natsfr/kicad-components/python_plugins/README

Use of foot print wizard:
 - Linux: ~/.kicad_plugins/
 - Windows: InstallPath\KiCad\share\kicad\scripting\plugins
