natsfr/kicad-components/python_plugins/qfn_generator_1.png

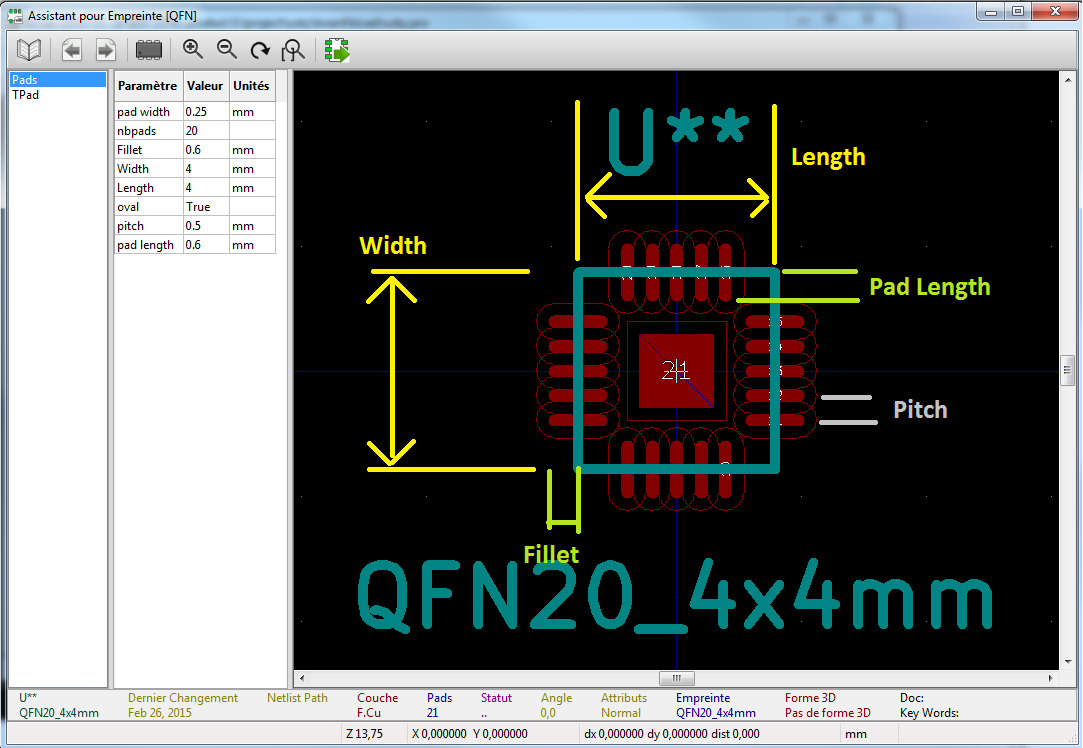
python_plugins/qfn_generator_1.png
