natsfr/kicad-components/python_plugins/qfn_generator_2.png

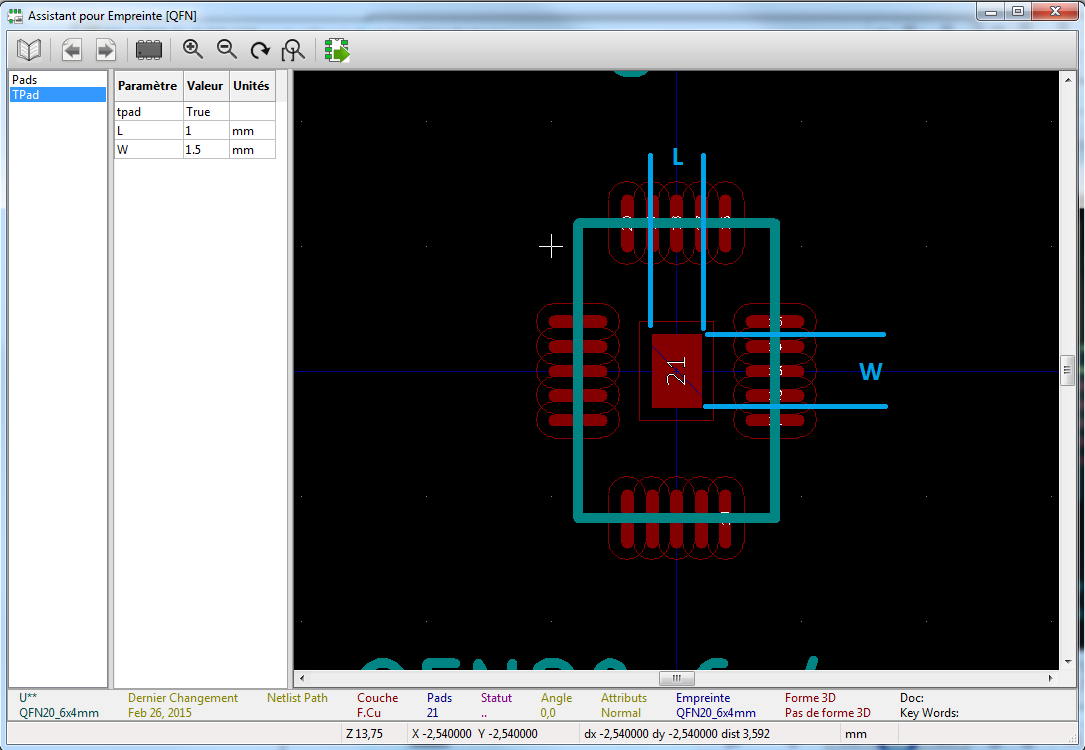
python_plugins/qfn_generator_2.png
