natsfr/kicad-components/python_plugins/qfn_generator_3.png

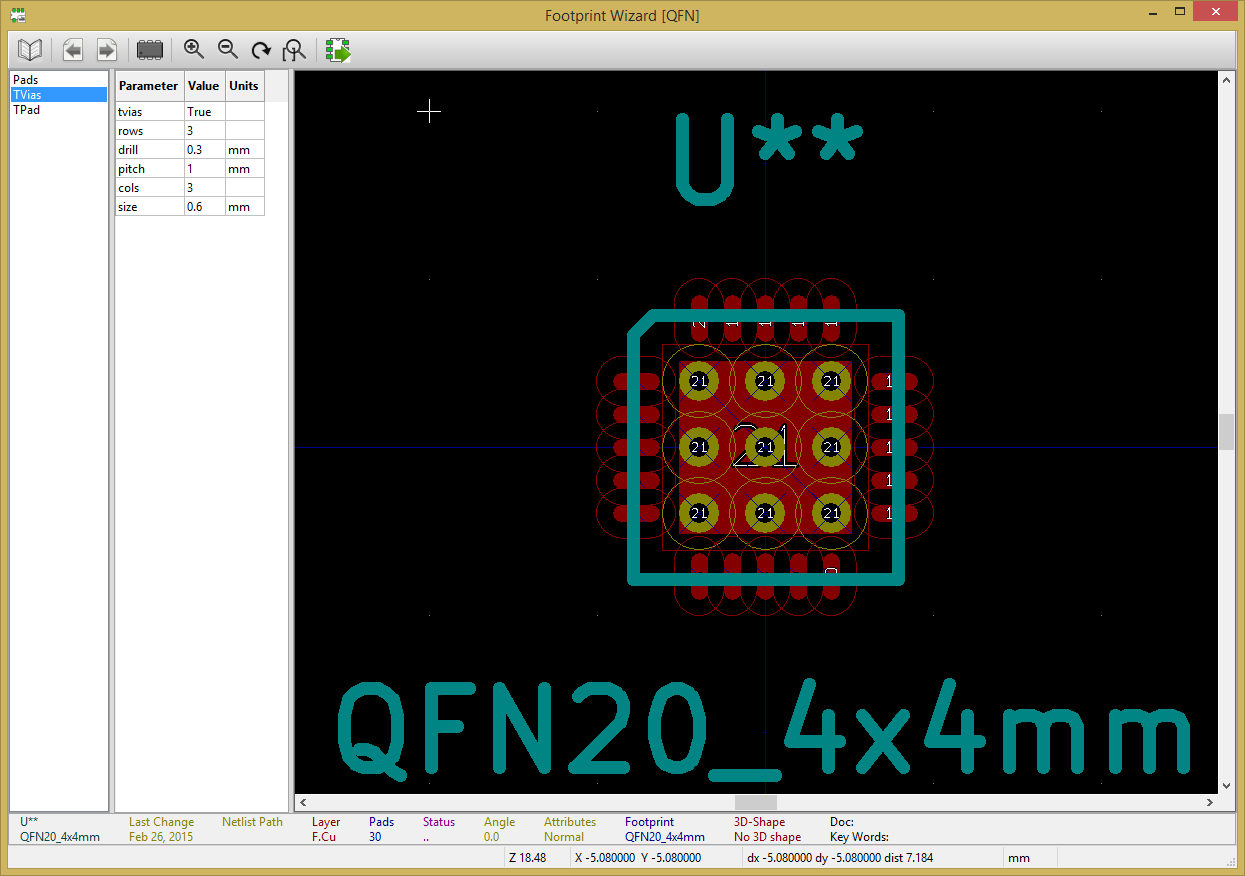
python_plugins/qfn_generator_3.png
