natsfr/kicad-components/3D_Models/Cherry/asm_mx_asm_PCB.stp

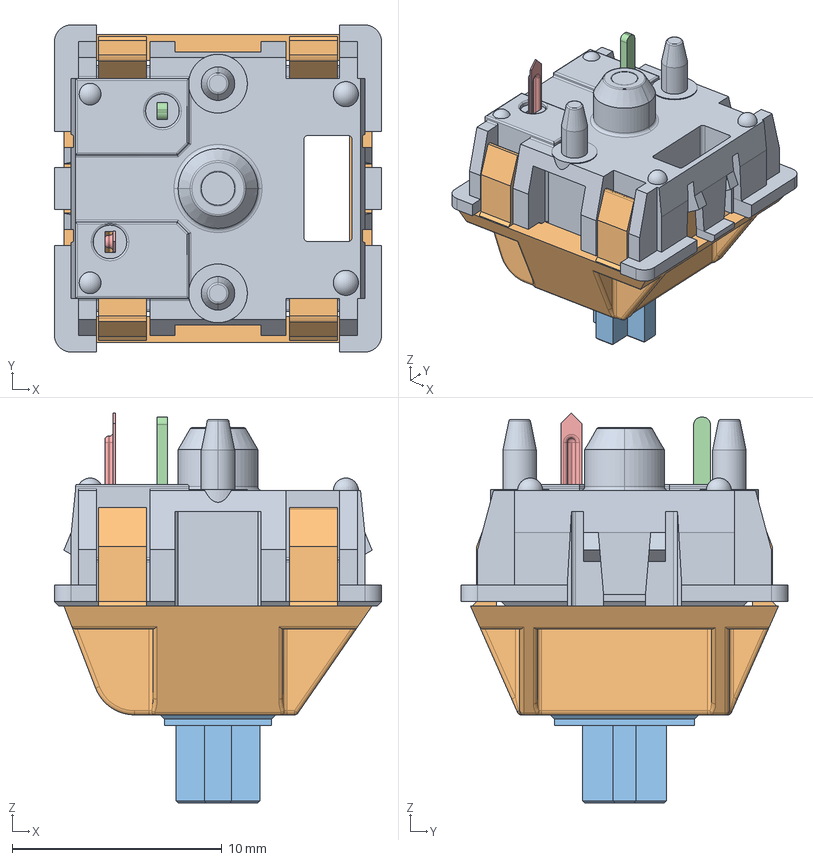
[picture p4: CAD file, 2021-11-10]
3D_Models/Cherry/asm_mx_asm_PCB.stp
15.6 x 15.6 x 18.6 mm
MX_DOWN
MX_UP
UP_MX
MX_PIN
MX_SPRING
MX_CLICK
