natsfr/kicad-components/3D_Models/Laird/bmi-s-209-assembly-stp-file.STEP

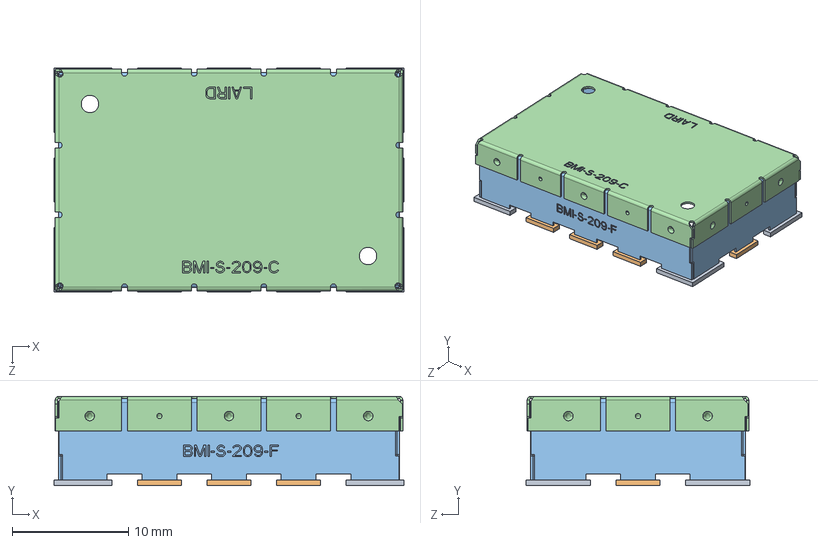
[picture p5: CAD file, 2021-12-20]
3D_Models/Laird/bmi-s-209-assembly-stp-file.STEP
30.2 x 7.70 x 19.3 mm
bmi-s-209-footprint
bmi-s-209-f
bmi-s-209-c
