natsfr/kicad-components/3D_Models/Connectors_RF/SMA_CINCH_142-0701-801_complete.step

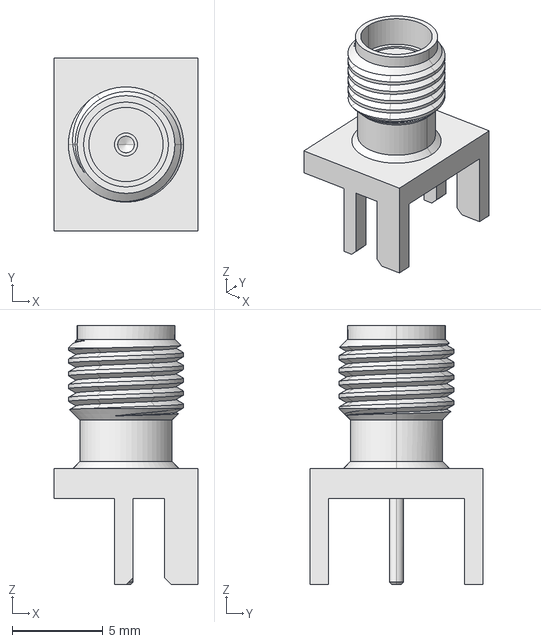
[picture p6: CAD file, 2019-05-17]
3D_Models/Connectors_RF/SMA_CINCH_142-0701-801_complete.step
7.92 x 9.53 x 14.3 mm
