natsfr/kicad-components/3D_Models/ALPS/SKSUBCE010.step

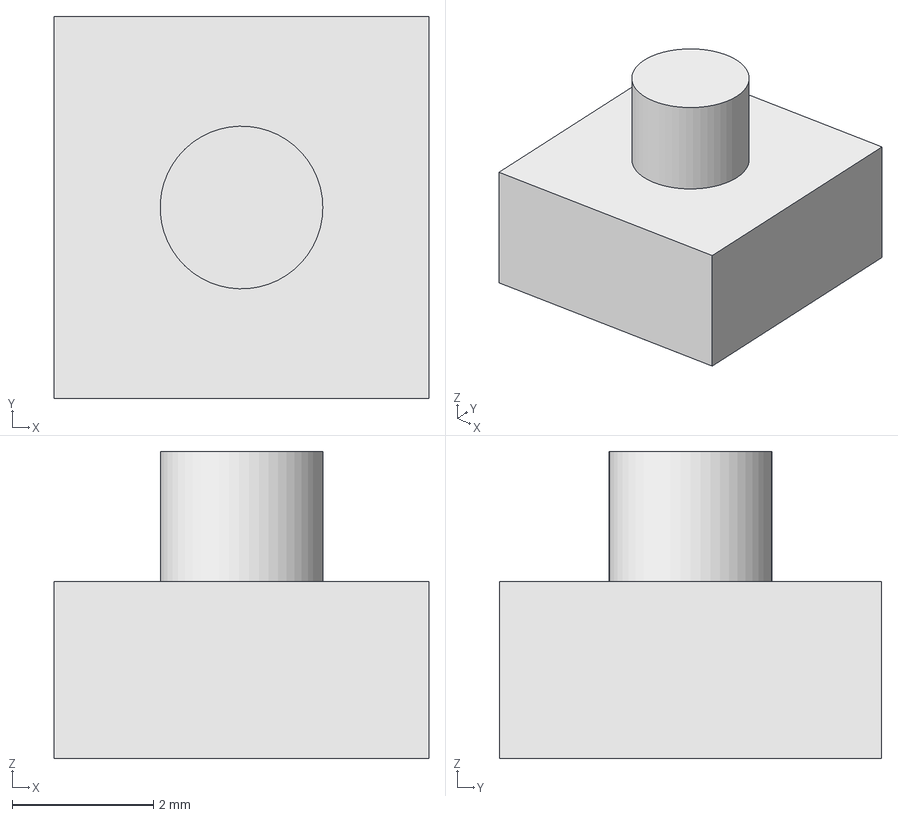
[picture p7: CAD file, 2024-10-08]
3D_Models/ALPS/SKSUBCE010.step
5.30 x 5.40 x 4.34 mm
