natsfr/kicad-components/3D_Models/Amphenol/SFP-U77A1118X00X.STEP

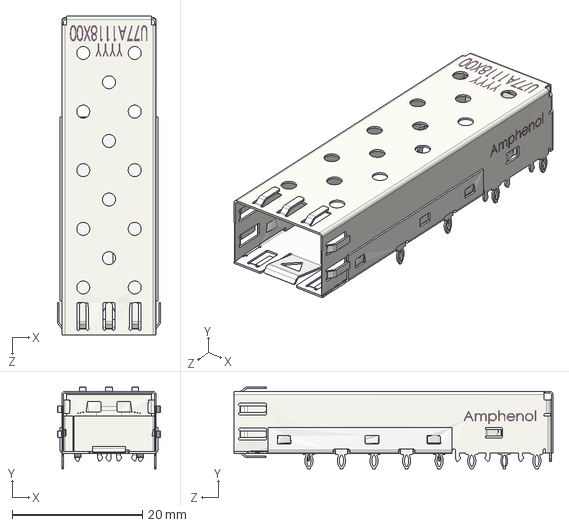
[picture p8: CAD file, 2021-12-20]
3D_Models/Amphenol/SFP-U77A1118X00X.STEP
15.8 x 12.6 x 49.0 mm
