natsfr/kicad-components/3D_Models/Antenna/custom_868.step

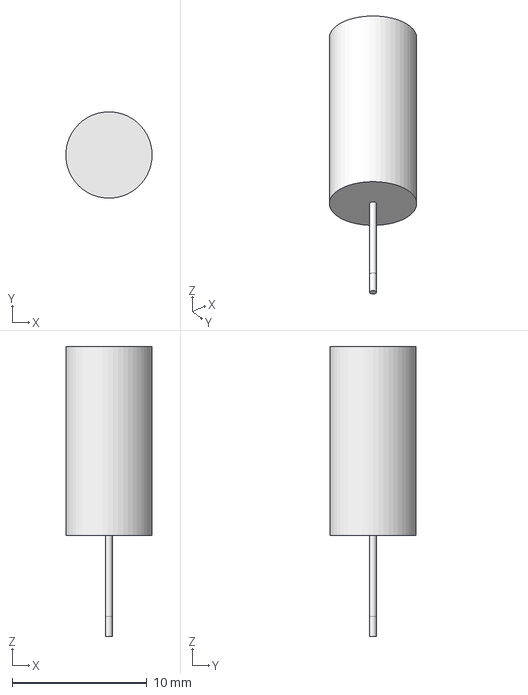
[picture p9: CAD file, 2024-10-08]
3D_Models/Antenna/custom_868.step
6.39 x 6.40 x 21.5 mm
