natsfr/kicad-components/3D_Models/Basic/3.2x2.5x2.5mm.step

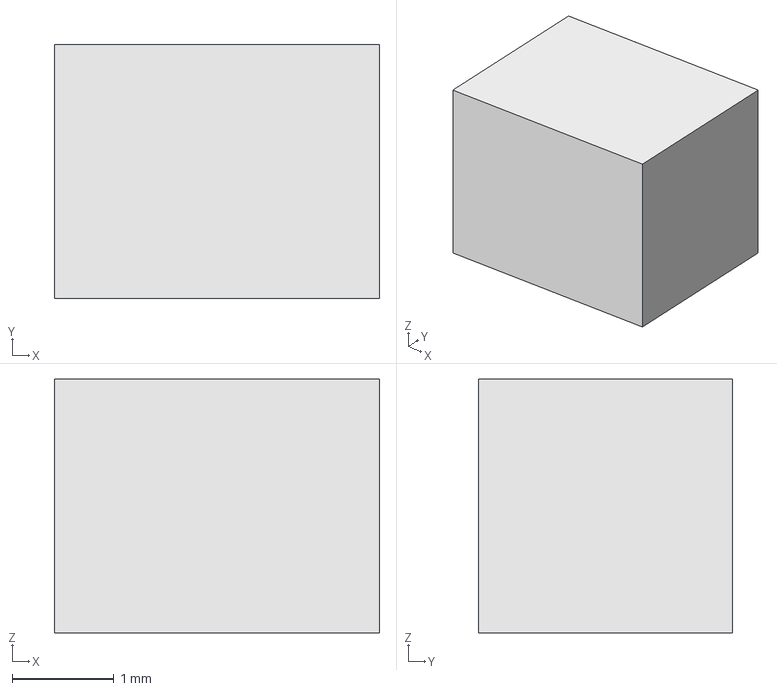
[picture p10: CAD file, 2026-04-01]
3D_Models/Basic/3.2x2.5x2.5mm.step
3.20 x 2.50 x 2.50 mm
