natsfr/kicad-components/3D_Models/Bourns/2038-xx-sm.stp

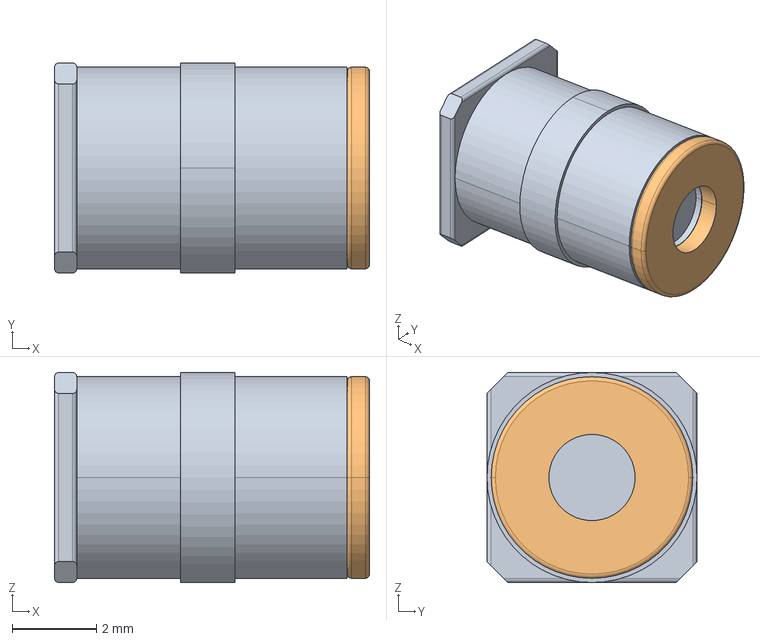
[picture p11: CAD file, 2026-08-12]
3D_Models/Bourns/2038-xx-sm.stp
7.50 x 5.00 x 5.00 mm
