natsfr/kicad-components/3D_Models/CK_Switch/KSC441J DCT.stp

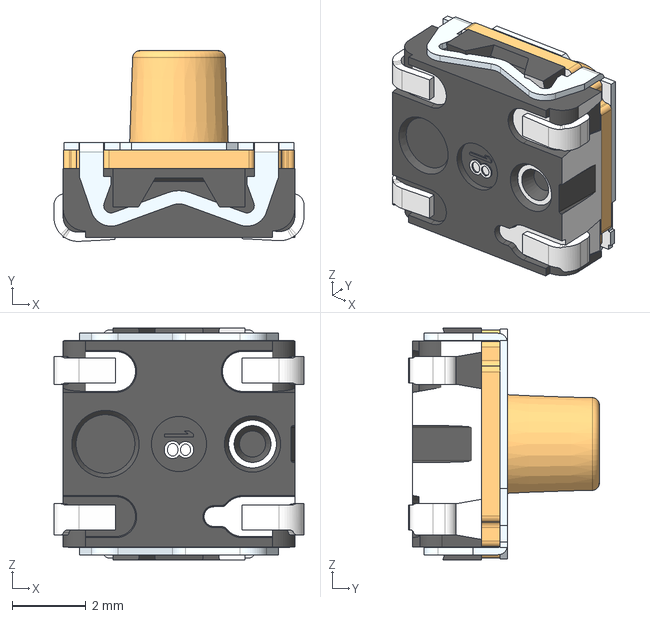
[picture p12: CAD file, 2020-06-26]
3D_Models/CK_Switch/KSC441J DCT.stp
6.80 x 5.19 x 6.30 mm
