natsfr/kicad-components/3D_Models/Coilcraft/Coilcraft-MSD7342.STEP

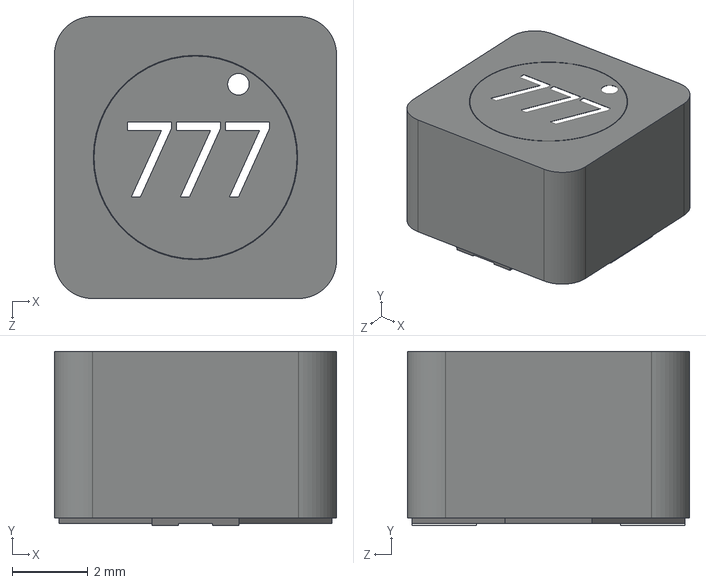
[picture p13: CAD file, 2025-06-05]
3D_Models/Coilcraft/Coilcraft-MSD7342.STEP
7.45 x 4.60 x 7.45 mm
