natsfr/kicad-components/3D_Models/ComputeUnit/PinSocket_2x13_P2.54mm_Vertical.step

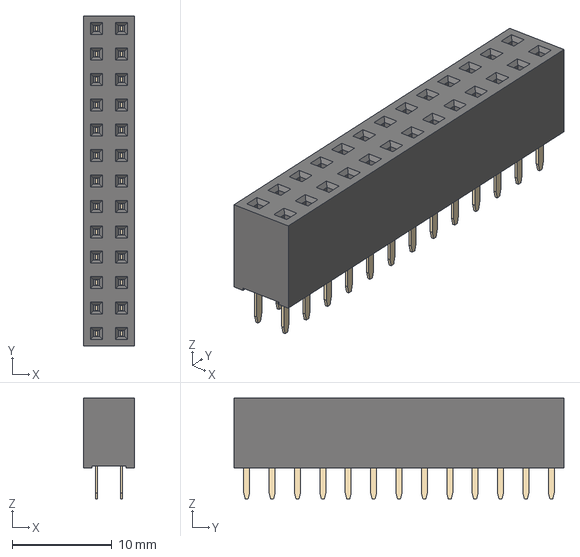
[picture p14: CAD file, 2022-07-30]
3D_Models/ComputeUnit/PinSocket_2x13_P2.54mm_Vertical.step
5.08 x 33.0 x 10.1 mm
