natsfr/kicad-components/3D_Models/Connector_0.8mm/QTE-014-03-F-D-DP-A.stp

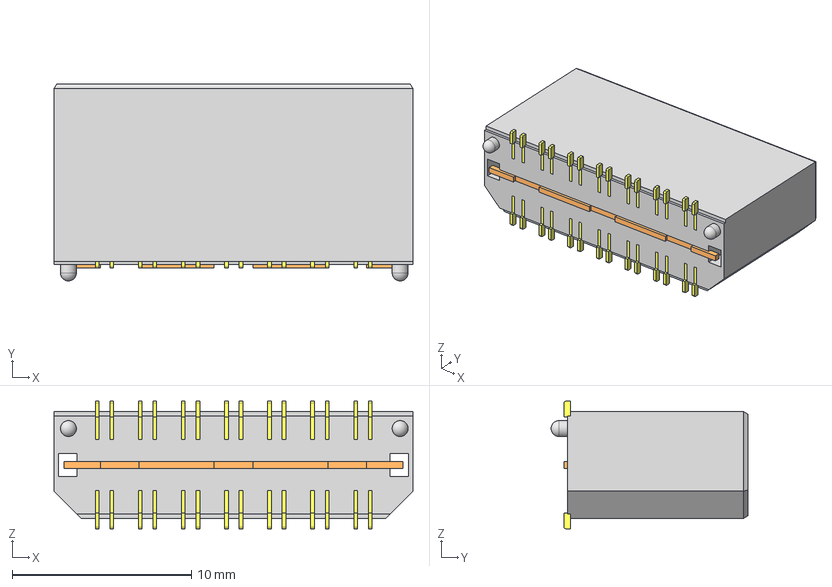
[picture p15: CAD file, 2022-07-30]
3D_Models/Connector_0.8mm/QTE-014-03-F-D-DP-A.stp
20.0 x 11.0 x 7.11 mm
_QTE-014-03-D-DP-At
_PT-1S60-03(014-03-D-DP)
_QTE-T-1G1-03_imp
