natsfr/kicad-components/3D_Models/Connector_1.27mm/FTS-110-01-L-D.stp

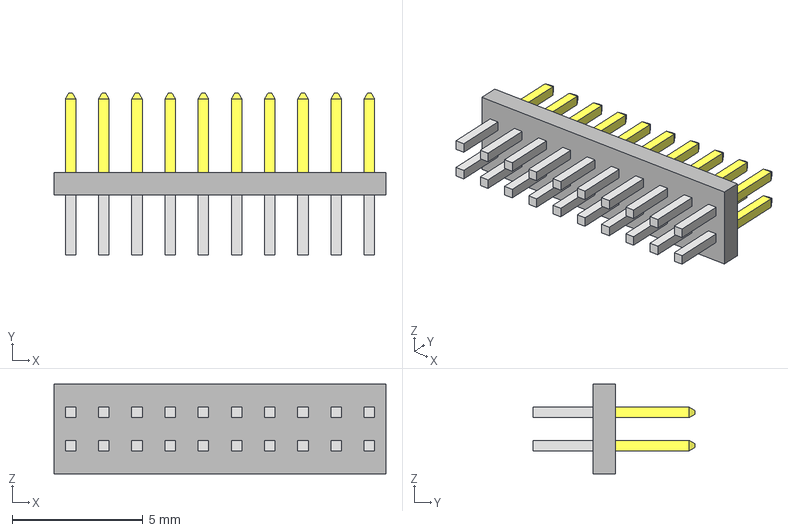
[picture p16: CAD file, 2019-06-12]
3D_Models/Connector_1.27mm/FTS-110-01-L-D.stp
12.7 x 6.20 x 3.43 mm
_FTS-110-01-L-D_body
_FTS-110-01-L-D_pins1
_FTS-110-01-L-D_pins2
