natsfr/kicad-components/3D_Models/Connectors_RF/SMA ANGLED.STEP

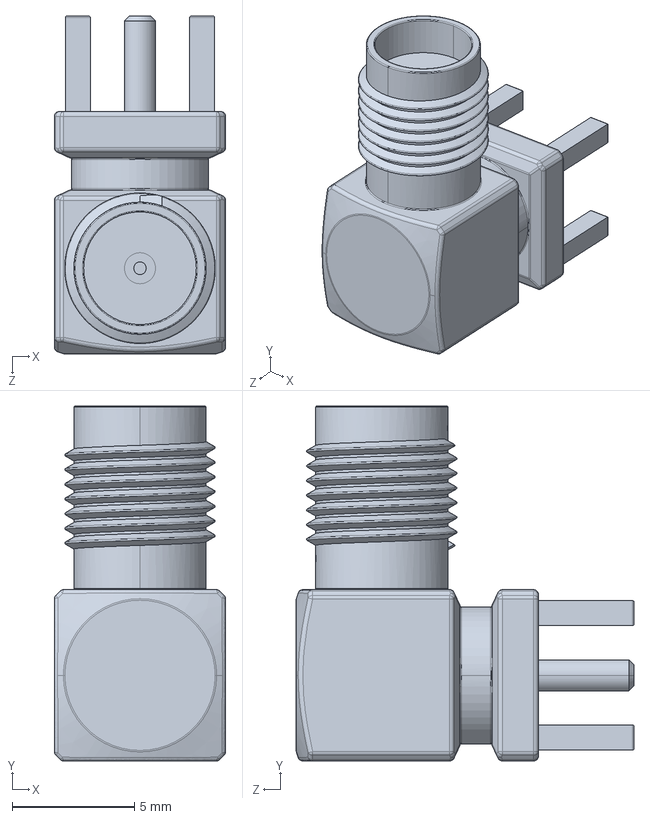
[picture p17: CAD file, 2021-12-20]
3D_Models/Connectors_RF/SMA ANGLED.STEP
7.00 x 14.5 x 13.8 mm
