natsfr/kicad-components/3D_Models/Cree/Cree_ML-X.STEP

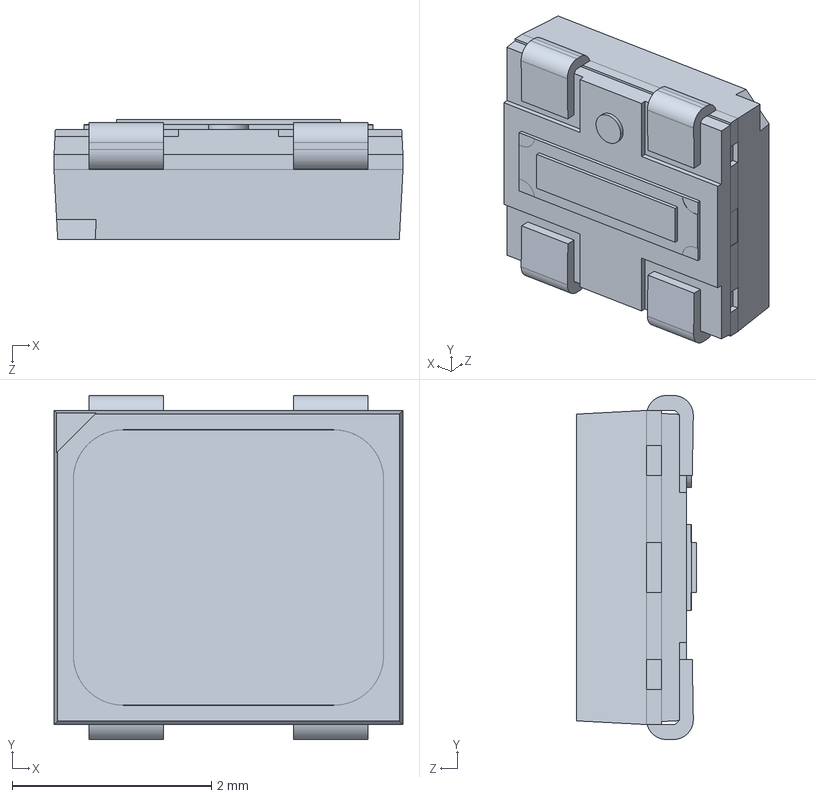
[picture p18: CAD file, 2022-07-30]
3D_Models/Cree/Cree_ML-X.STEP
3.50 x 3.45 x 1.20 mm
