natsfr/kicad-components/3D_Models/Display/OLED_128x64.stp

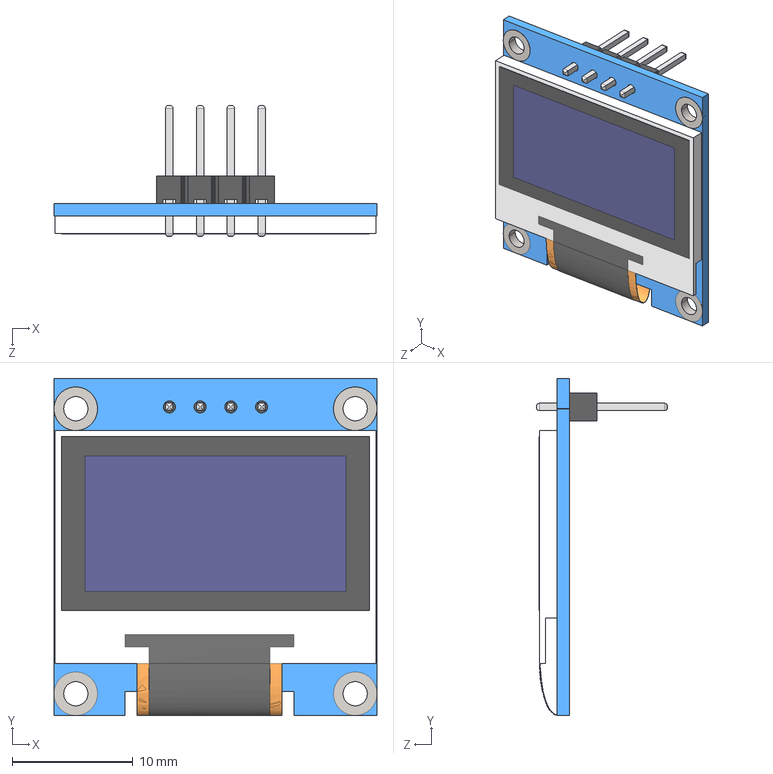
[picture p19: CAD file, 2021-11-10]
3D_Models/Display/OLED_128x64.stp
26.7 x 27.9 x 10.8 mm
