natsfr/kicad-components/3D_Models/DPAK/DPAK_TO252.STEP

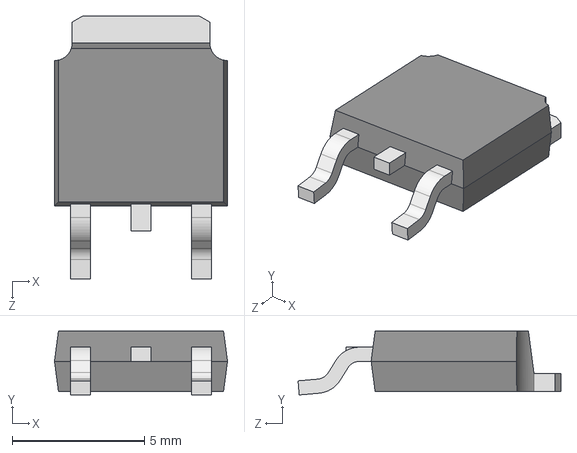
[picture p20: CAD file, 2021-12-28]
3D_Models/DPAK/DPAK_TO252.STEP
6.54 x 2.42 x 9.94 mm
