natsfr/kicad-components/3D_Models/ELNA/DBJ_13.5mm.step

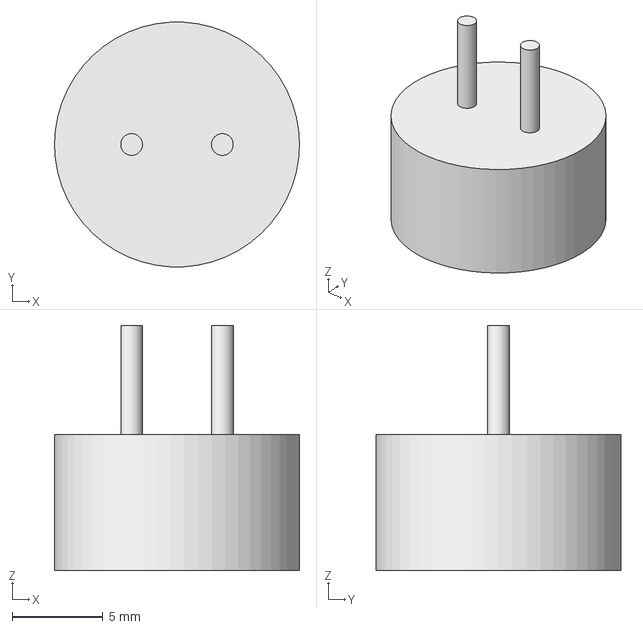
[picture p21: CAD file, 2023-07-08]
3D_Models/ELNA/DBJ_13.5mm.step
13.5 x 13.5 x 13.5 mm
