natsfr/kicad-components/3D_Models/FCI/SATA_10035692-011.STEP

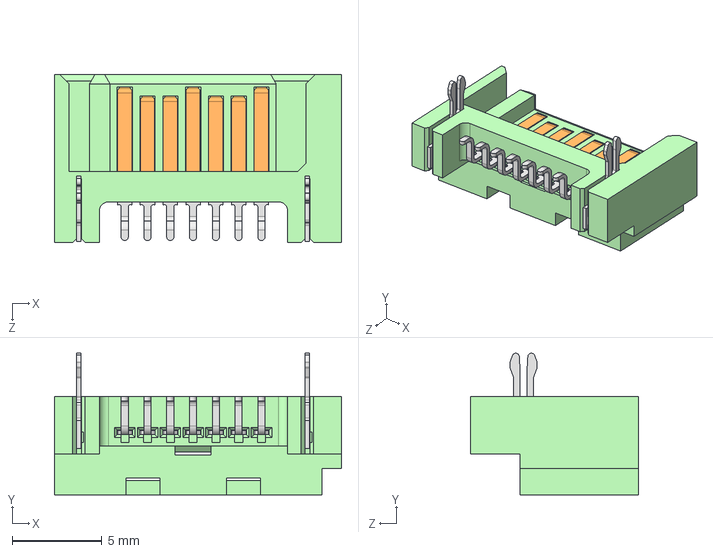
[picture p22: CAD file, 2020-09-30]
3D_Models/FCI/SATA_10035692-011.STEP
16.0 x 7.90 x 9.35 mm
