natsfr/kicad-components/3D_Models/Hirose/DM3D-SF.step

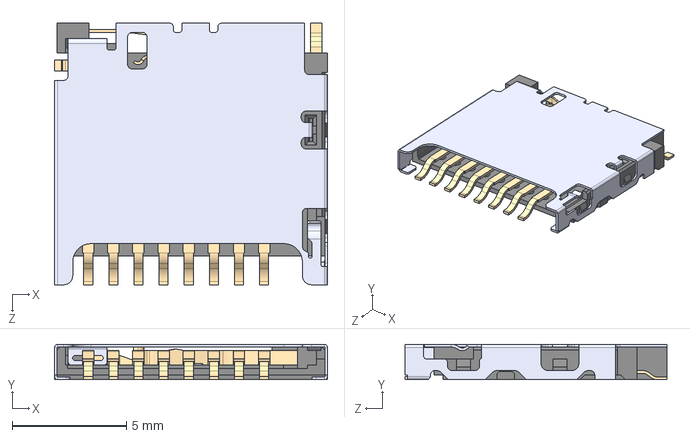
[picture p23: CAD file, 2025-08-20]
3D_Models/Hirose/DM3D-SF.step
12.0 x 1.55 x 11.5 mm
