natsfr/kicad-components/3D_Models/JST/B2PS-VH.stp

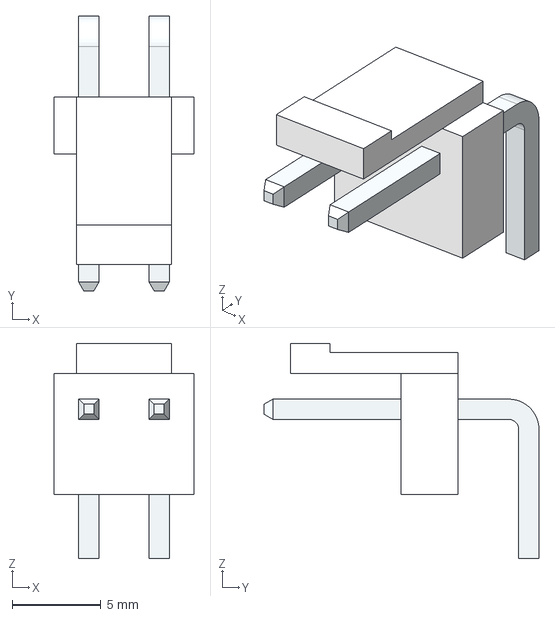
[picture p24: CAD file, 2025-07-04]
3D_Models/JST/B2PS-VH.stp
7.86 x 15.5 x 12.1 mm
