natsfr/kicad-components/3D_Models/Lumberg/lumberg_0105_05.stp

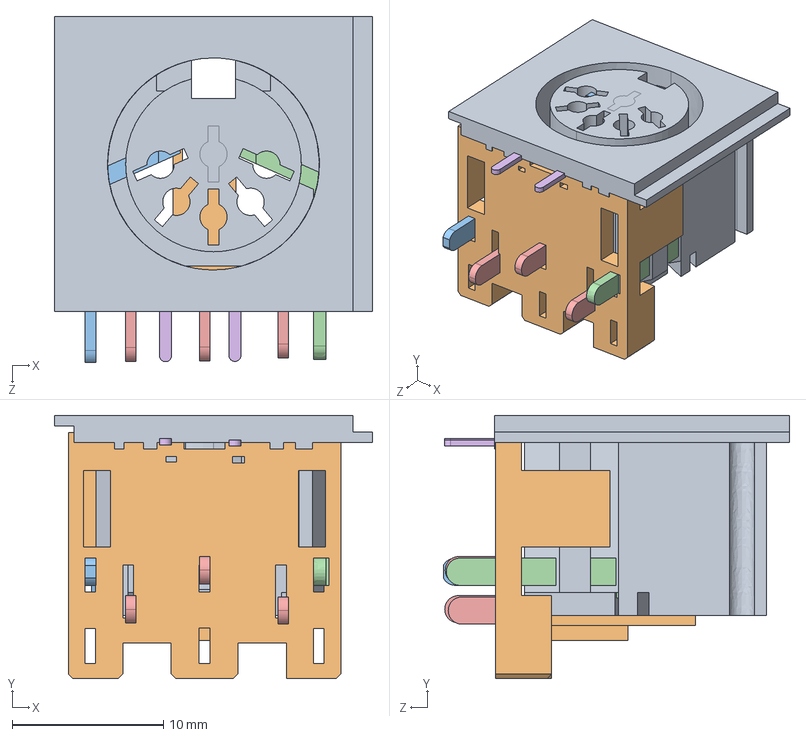
[picture p25: CAD file, 2023-05-27]
3D_Models/Lumberg/lumberg_0105_05.stp
21.0 x 17.4 x 22.9 mm
PRT0017
PRT0018
PRT0019
PRT0020
PRT0021
PRT0022
PRT0022_1
PRT0023
PRT0024
