natsfr/kicad-components/3D_Models/Macom/etc1-1-13.step

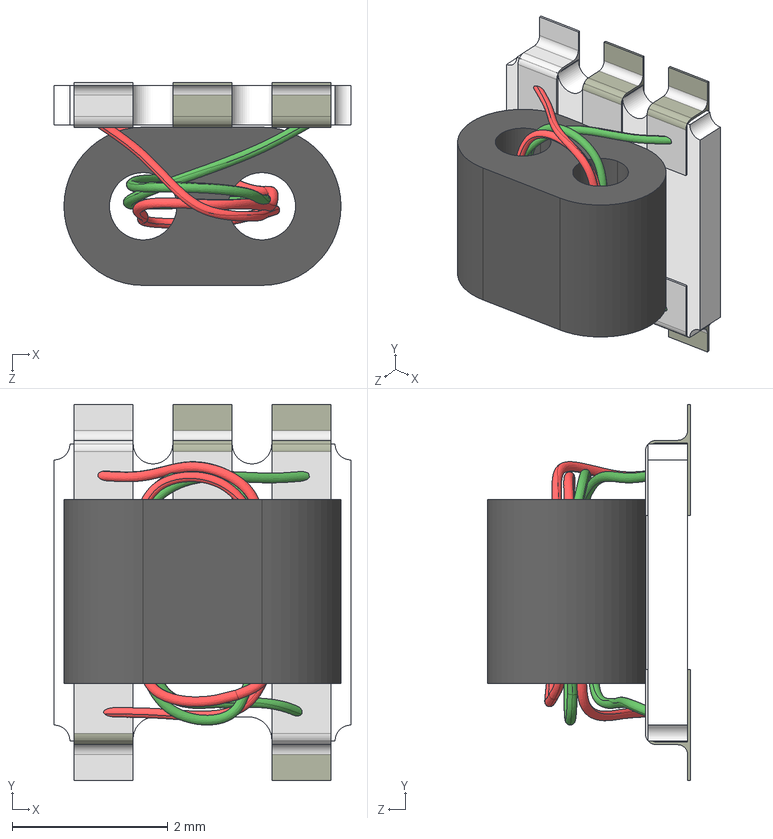
[picture p26: CAD file, 2023-07-08]
3D_Models/Macom/etc1-1-13.step
3.81 x 4.83 x 2.60 mm
