natsfr/kicad-components/3D_Models/Masach/ms488-10f-ns.stp

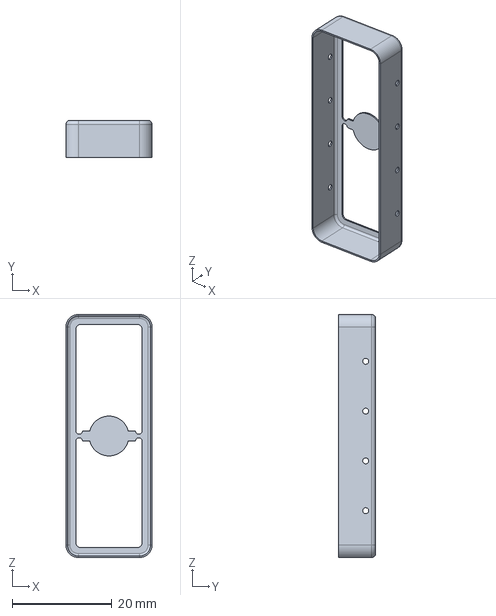
[picture p27: CAD file, 2026-05-14]
3D_Models/Masach/ms488-10f-ns.stp
17.3 x 7.50 x 48.8 mm
