natsfr/kicad-components/3D_Models/Meanwell/RSDW60G-12.step

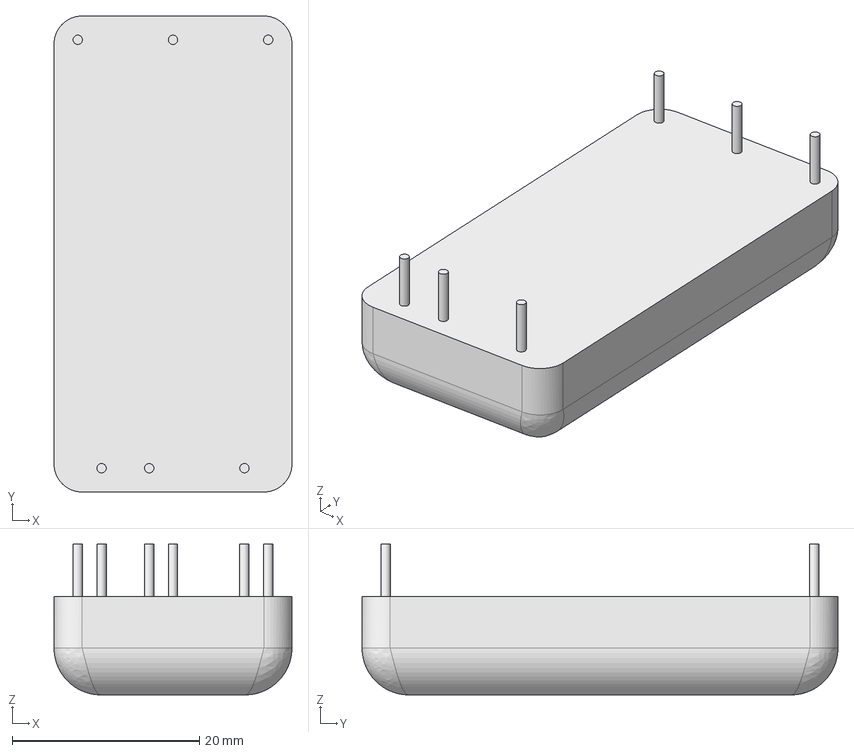
[picture p28: CAD file, 2026-08-12]
3D_Models/Meanwell/RSDW60G-12.step
25.4 x 50.8 x 16.1 mm
