natsfr/kicad-components/3D_Models/MiniCircuit/User Library-DB1627.STEP

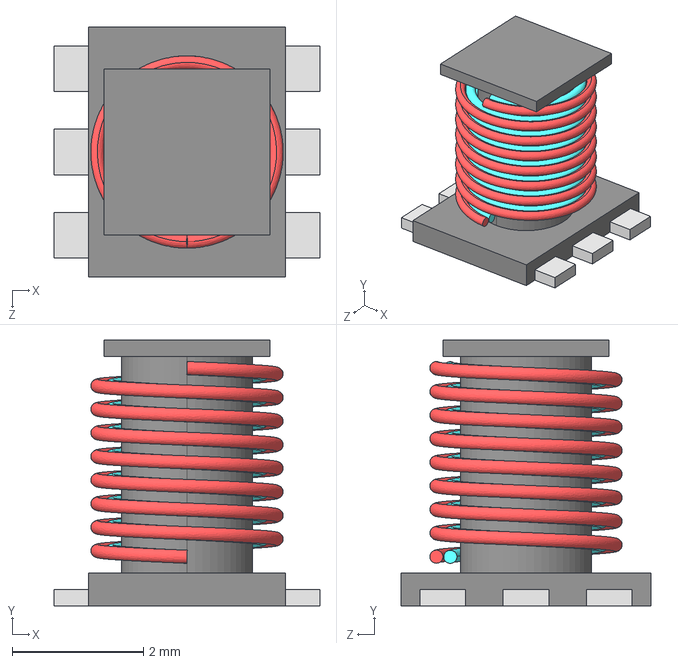
[picture p29: CAD file, 2024-10-08]
3D_Models/MiniCircuit/User Library-DB1627.STEP
4.06 x 4.06 x 3.82 mm
