natsfr/kicad-components/3D_Models/Mitsubishi/fair-rite_2661000101.step

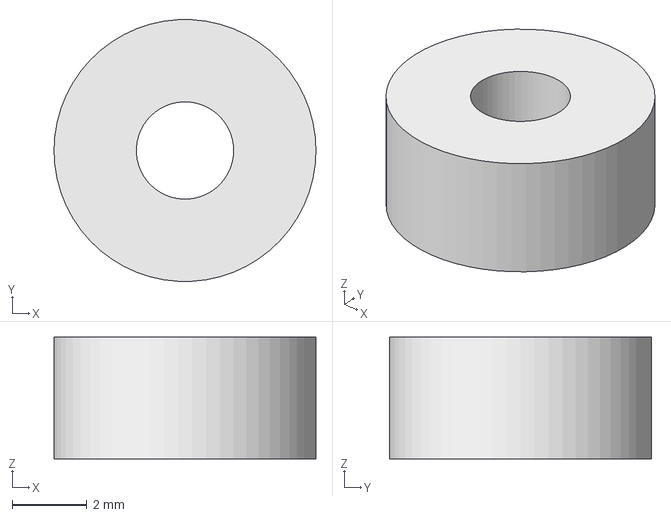
[picture p30: CAD file, 2022-07-30]
3D_Models/Mitsubishi/fair-rite_2661000101.step
7.00 x 6.99 x 3.25 mm
