natsfr/kicad-components/3D_Models/Omron/a6fr-5101.stp

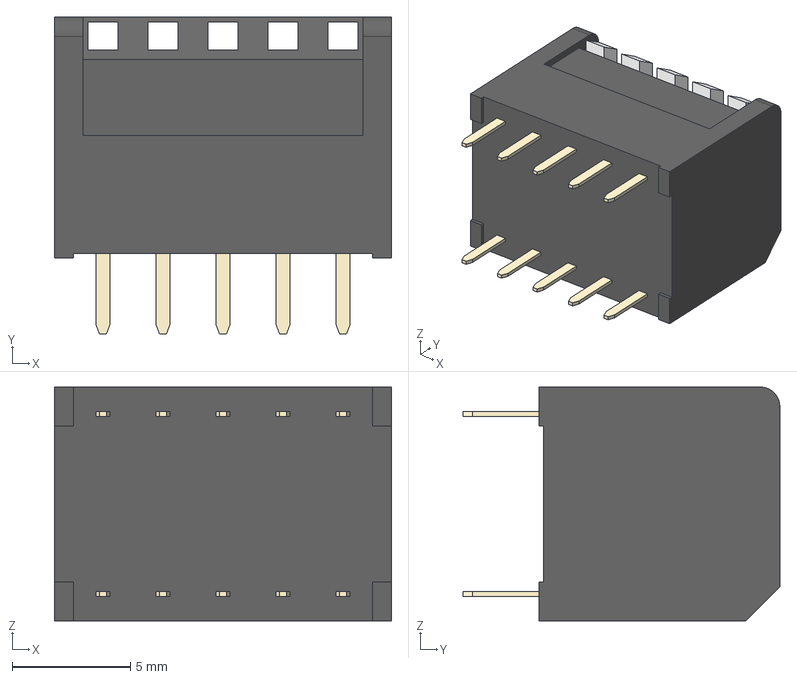
[picture p31: CAD file, 2020-07-26]
3D_Models/Omron/a6fr-5101.stp
14.3 x 13.4 x 9.90 mm
