natsfr/kicad-components/3D_Models/OnSemi/MicroFC_30035.step

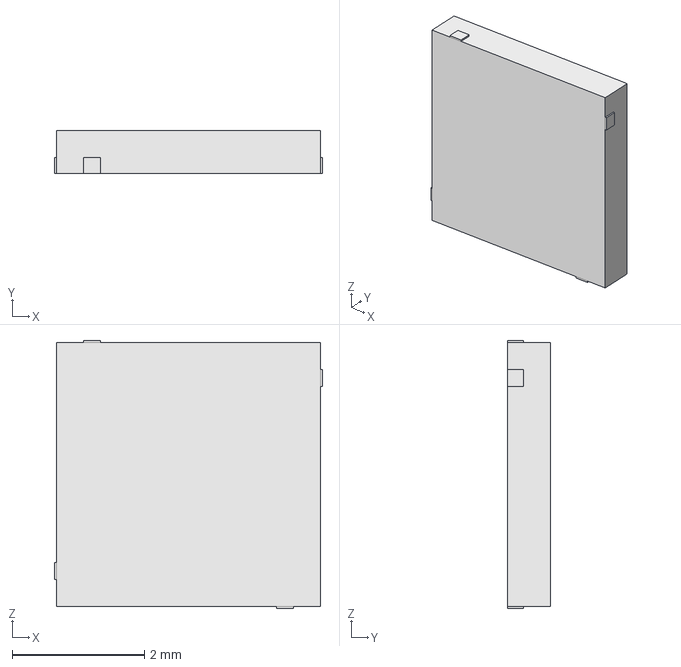
[picture p32: CAD file, 2020-06-26]
3D_Models/OnSemi/MicroFC_30035.step
4.06 x 0.65 x 4.06 mm
