natsfr/kicad-components/3D_Models/ONSHORE/USB-B1HSB6.step

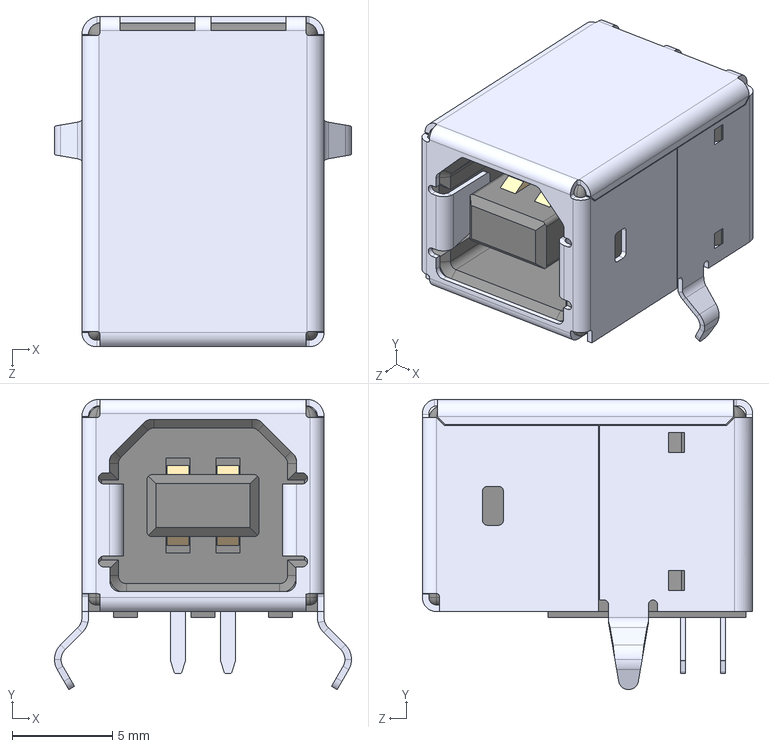
[picture p33: CAD file, 2023-11-21]
3D_Models/ONSHORE/USB-B1HSB6.step
14.8 x 14.5 x 16.5 mm
