natsfr/kicad-components/3D_Models/Panasonic_ECAP/SMD_FC_V_10x10.2mm.stp

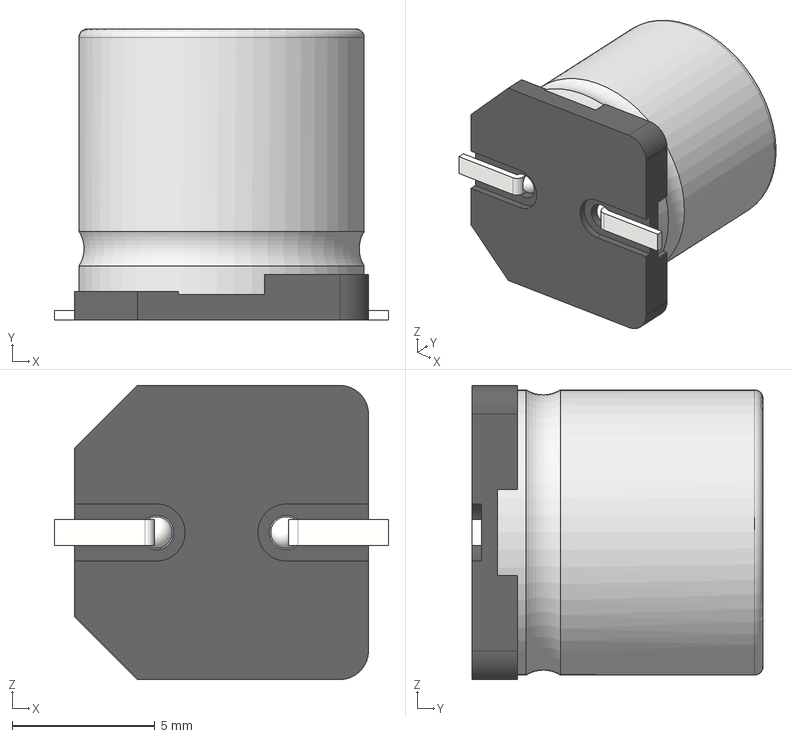
[picture p34: CAD file, 2019-05-28]
3D_Models/Panasonic_ECAP/SMD_FC_V_10x10.2mm.stp
11.7 x 10.2 x 10.3 mm
標準品ケースΦ10x9.3L SIDE CODE G
標準品座版Φ10 SIZE CODE G
標準品リード線Φ10 SIZE CODE G改 x 2
