natsfr/kicad-components/3D_Models/Pulse/PA2754NL.step

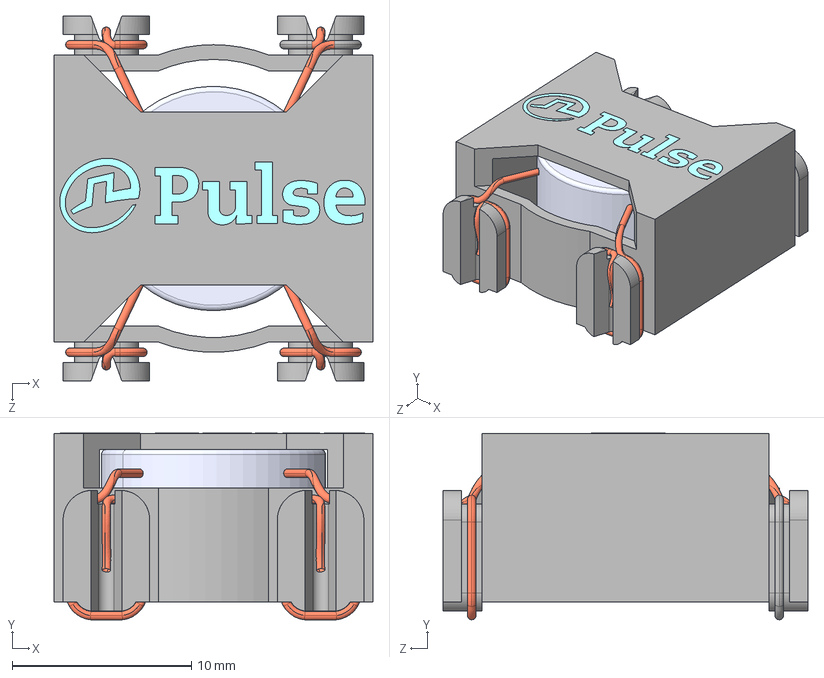
[picture p35: CAD file, 2026-08-12]
3D_Models/Pulse/PA2754NL.step
17.8 x 10.4 x 20.3 mm
032-PA2755
Pulse Logo
