natsfr/kicad-components/3D_Models/Riverdi/3D_RVT43HLTFWN00_Rev.1.1.stp

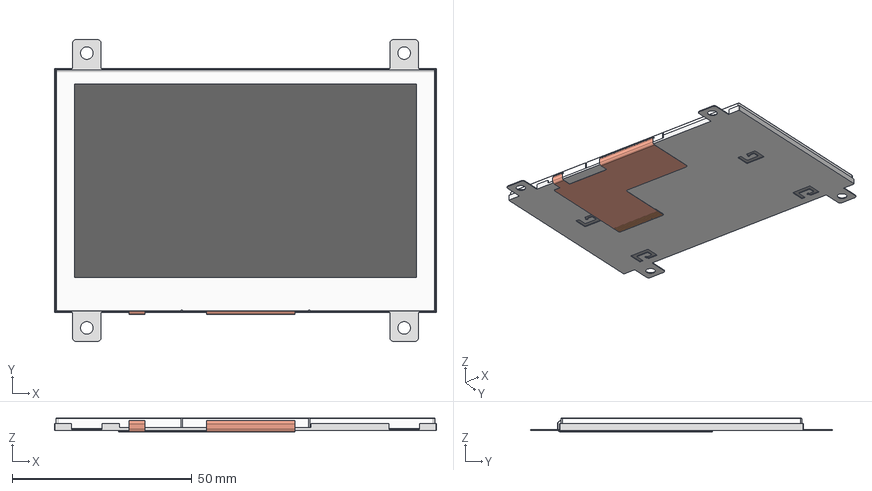
[picture p36: CAD file, 2023-07-08]
3D_Models/Riverdi/3D_RVT43HLTFWN00_Rev.1.1.stp
106.3 x 84.0 x 3.92 mm
FRAME_1
DST
DISP
FPC
