natsfr/kicad-components/3D_Models/Samesky/Same_Sky_CDM804-08A-MP-R805-67.step

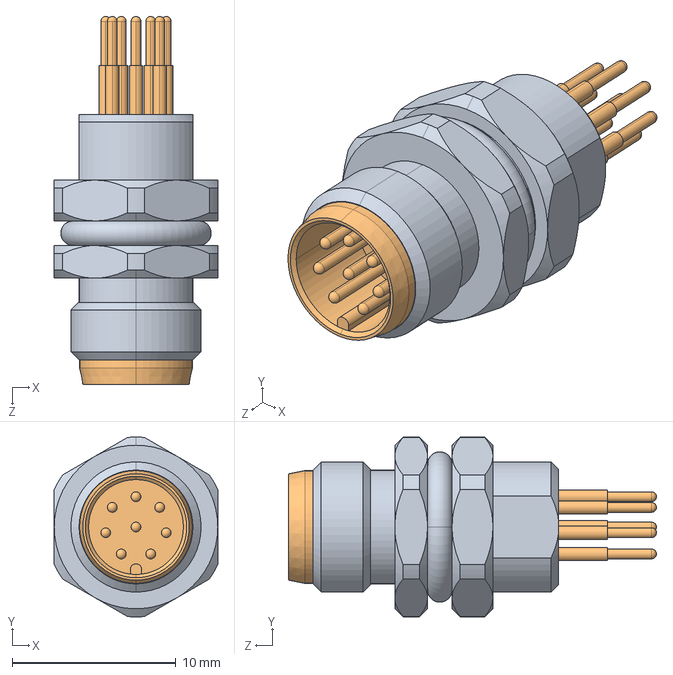
[picture p37: CAD file, 2024-11-25]
3D_Models/Samesky/Same_Sky_CDM804-08A-MP-R805-67.step
10.0 x 11.0 x 22.5 mm
CDM804 HOUSING
M8_PINS_MALE_FRONT_8P
