natsfr/kicad-components/3D_Models/Samtec/QSH-040-01-F-D-DP-RA.stp

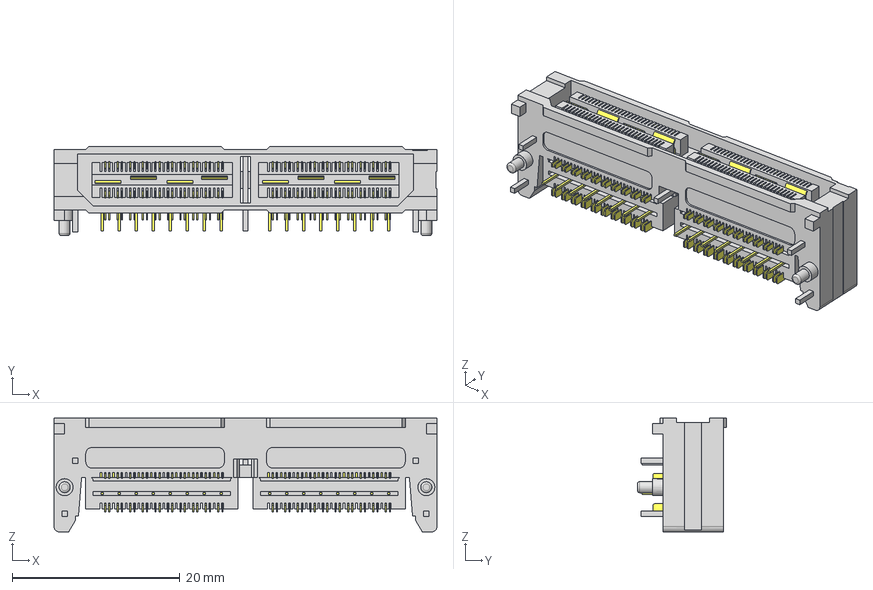
[picture p38: CAD file, 2026-04-20]
3D_Models/Samtec/QSH-040-01-F-D-DP-RA.stp
45.7 x 10.6 x 13.6 mm
QSH-040-1-D-DP-RAsc
IM-1G18-01-2-QSH_insert x 2
C-178-02-XXX/C-177-01-XXX_pins x 2
