natsfr/kicad-components/3D_Models/SOIC/PowerPAK SO-8.stp

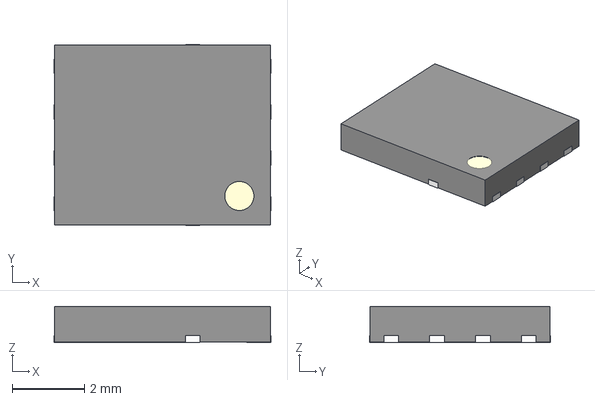
[picture p39: CAD file, 2025-09-23]
3D_Models/SOIC/PowerPAK SO-8.stp
6.02 x 5.02 x 1.00 mm
pins
