natsfr/kicad-components/3D_Models/SOT/SOT23-3.stp

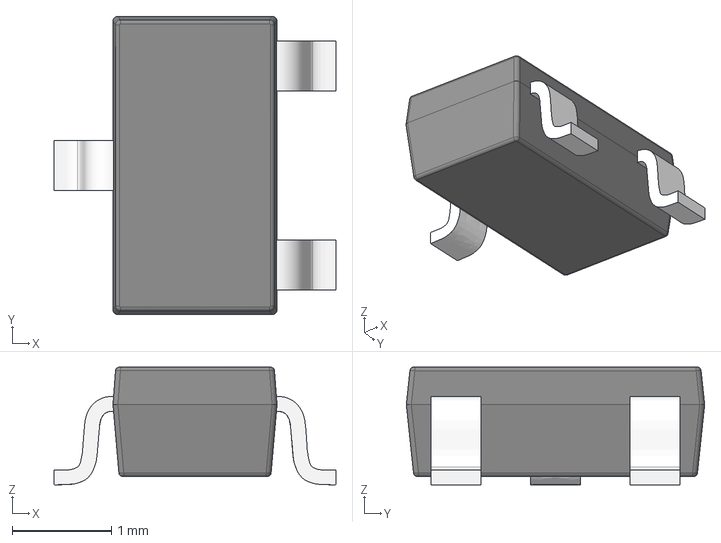
[picture p40: CAD file, 2019-11-22]
3D_Models/SOT/SOT23-3.stp
2.84 x 3.00 x 1.18 mm
