natsfr/kicad-components/3D_Models/SSOP/TSSOP-10.step

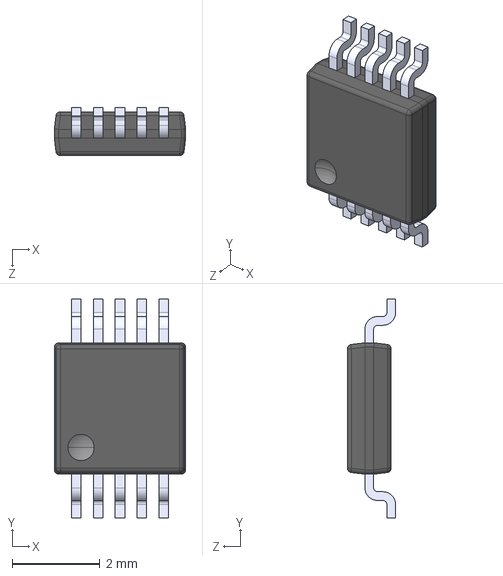
[picture p41: CAD file, 2023-07-08]
3D_Models/SSOP/TSSOP-10.step
3.00 x 5.00 x 1.10 mm
