natsfr/kicad-components/3D_Models/Standard/0805_2x1.25x1_capacitor.step

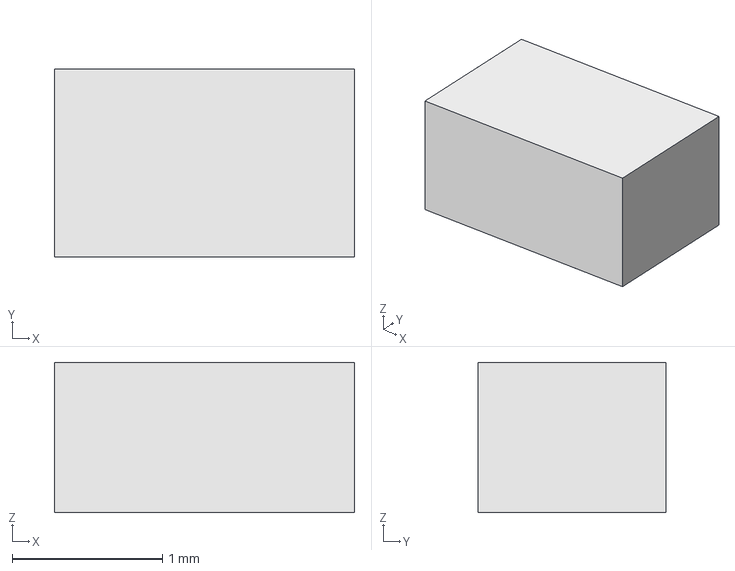
[picture p42: CAD file, 2019-10-08]
3D_Models/Standard/0805_2x1.25x1_capacitor.step
2.00 x 1.25 x 1.00 mm
