natsfr/kicad-components/3D_Models/TDK/FS1403.step

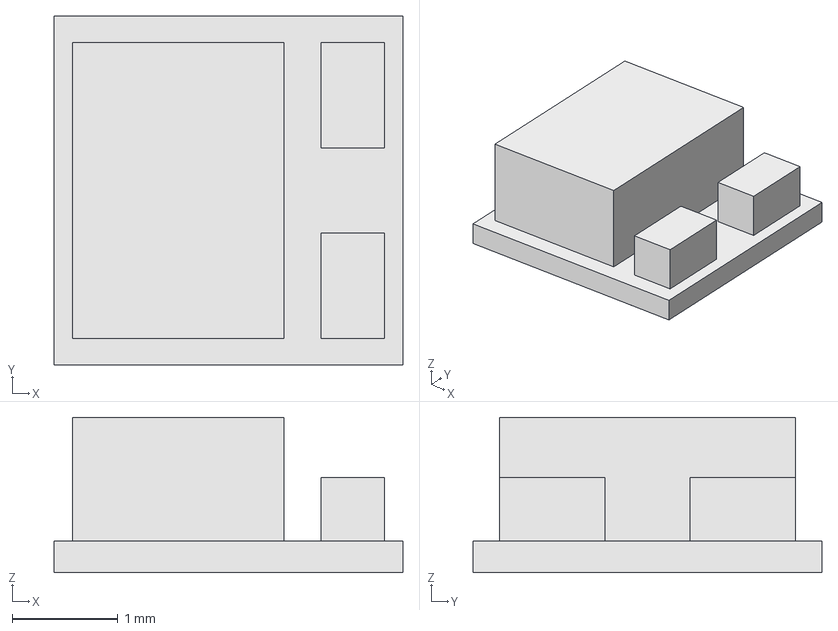
[picture p43: CAD file, 2026-09-18]
3D_Models/TDK/FS1403.step
3.30 x 3.30 x 1.47 mm
