natsfr/kicad-components/3D_Models/TE/c-1825968-2-b-3d.stp

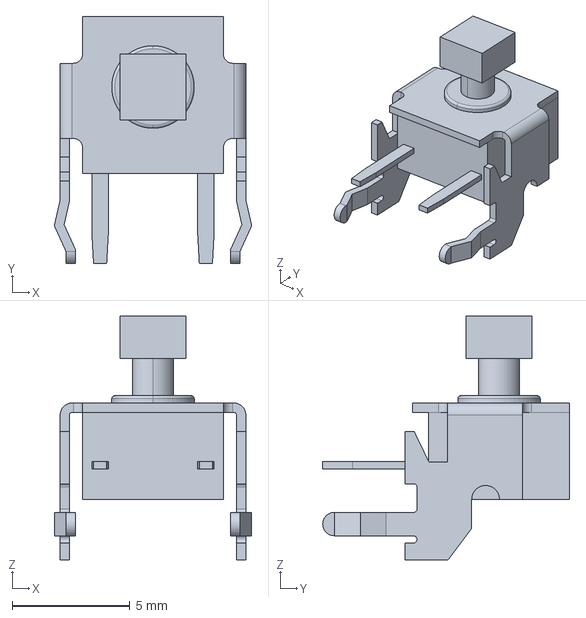
[picture p44: CAD file, 2025-08-20]
3D_Models/TE/c-1825968-2-b-3d.stp
8.40 x 10.5 x 10.4 mm
