natsfr/kicad-components/3D_Models/TI/HTQFP48.stp

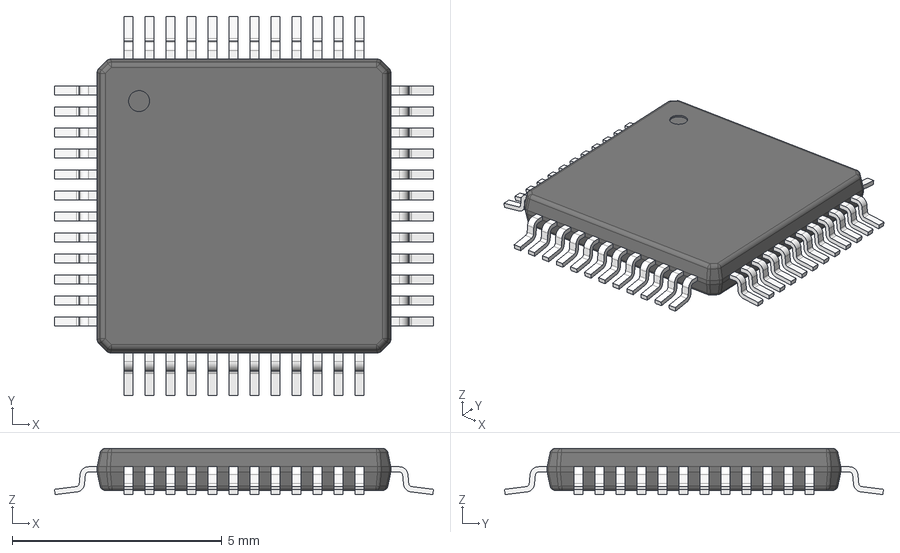
[picture p45: CAD file, 2023-07-08]
3D_Models/TI/HTQFP48.stp
9.03 x 9.03 x 1.10 mm
BODY-QFP
LEAD-QFP x 48
THERMALPAD
