natsfr/kicad-components/3D_Models/Ublox/u-blox_Max_M8.STEP

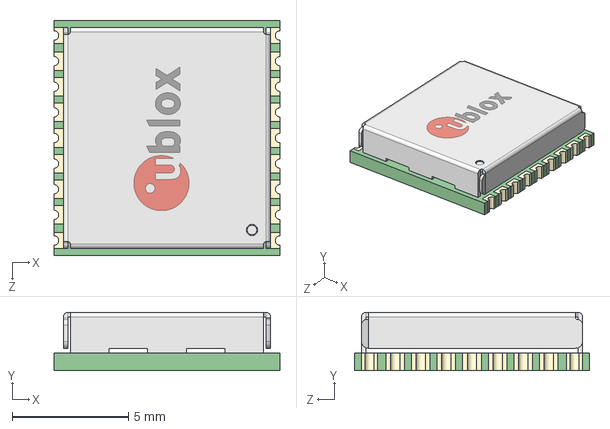
[picture p46: CAD file, 2023-07-08]
3D_Models/Ublox/u-blox_Max_M8.STEP
9.70 x 2.50 x 10.1 mm
