natsfr/kicad-components/3D_Models/WS2812B/WS2812_RGB_LED_updated.stp

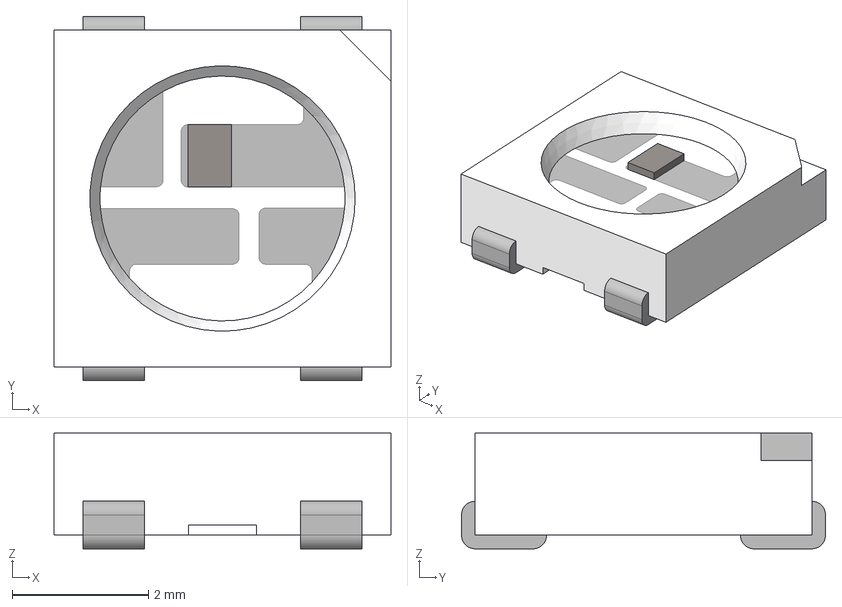
[picture p47: CAD file, 2023-05-27]
3D_Models/WS2812B/WS2812_RGB_LED_updated.stp
4.95 x 5.35 x 1.70 mm
