natsfr/kicad-components/3D_Models/Wurth_Ind/STEP_WE-PD_7345_STP_rev1.stp

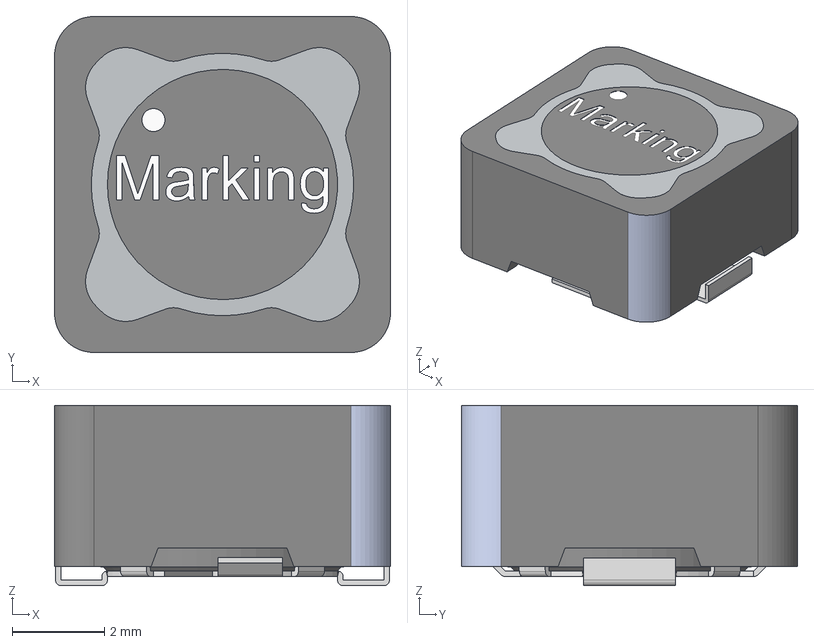
[picture p48: CAD file, 2024-10-08]
3D_Models/Wurth_Ind/STEP_WE-PD_7345_STP_rev1.stp
7.30 x 7.30 x 3.92 mm
Ring
Core
Base x 2
Glue x 3
