natsfr/kicad-components/3D_Models/Xilinx/CmodS7.step

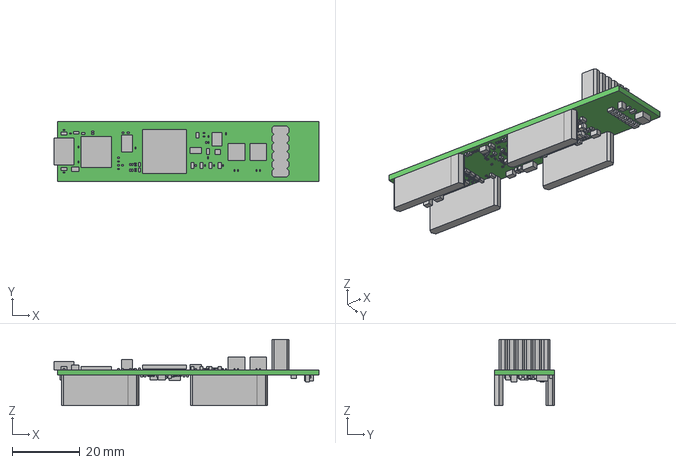
[picture p49: CAD file, 2023-05-27]
3D_Models/Xilinx/CmodS7.step
78.4 x 17.8 x 19.6 mm
Board
Extruded x 243
