natsfr/kicad-components/3D_Models/Xtals/Crystal Resonator 3.2x2.5mm.step

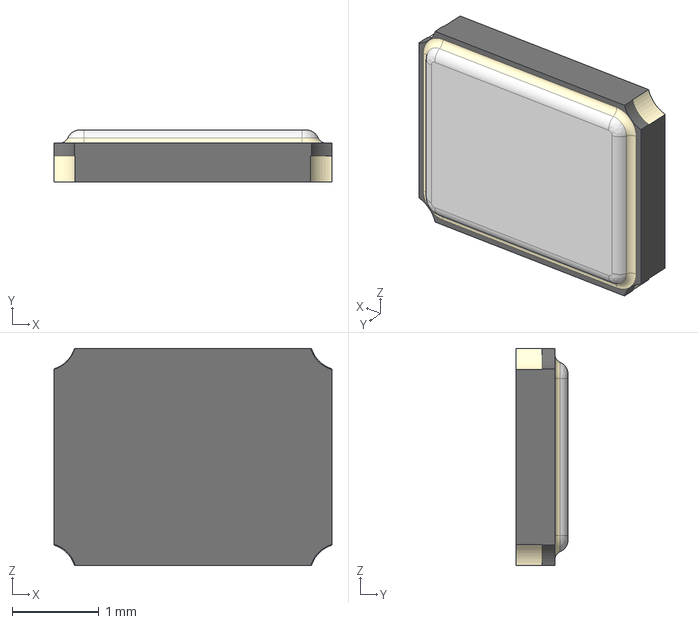
[picture p50: CAD file, 2022-07-30]
3D_Models/Xtals/Crystal Resonator 3.2x2.5mm.step
3.20 x 0.6 x 2.50 mm
