natsfr/kicad-components/3D_Models/ALPS/EC12E2424407.step

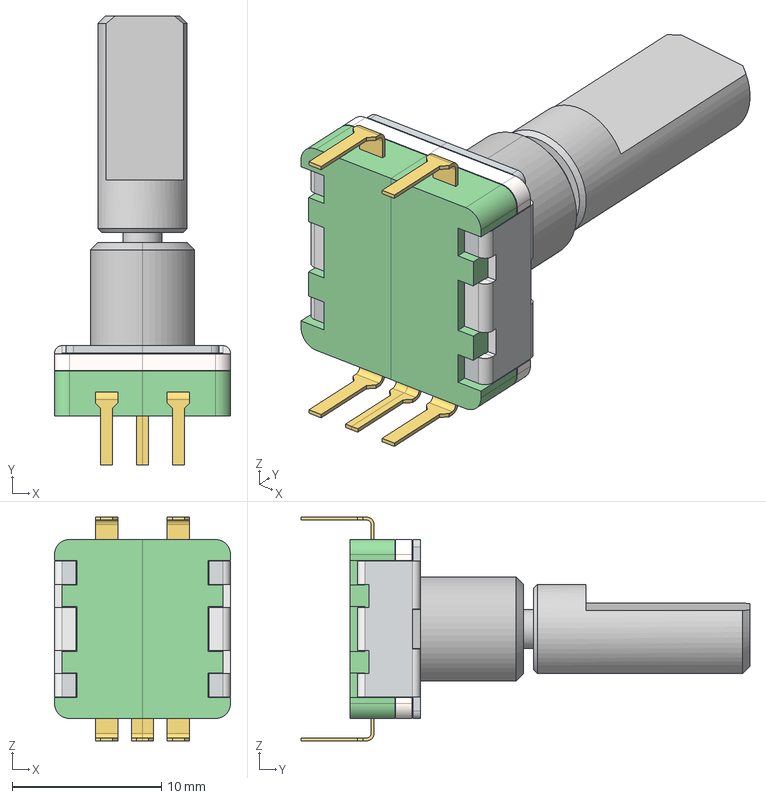
[picture p51: CAD file, 2020-06-26]
3D_Models/ALPS/EC12E2424407.step
11.8 x 30.1 x 15.0 mm
Rotary_Encoder
D-handle
