natsfr/kicad-components/3D_Models/Coilcraft/Coilcraft-1812SMS.STEP

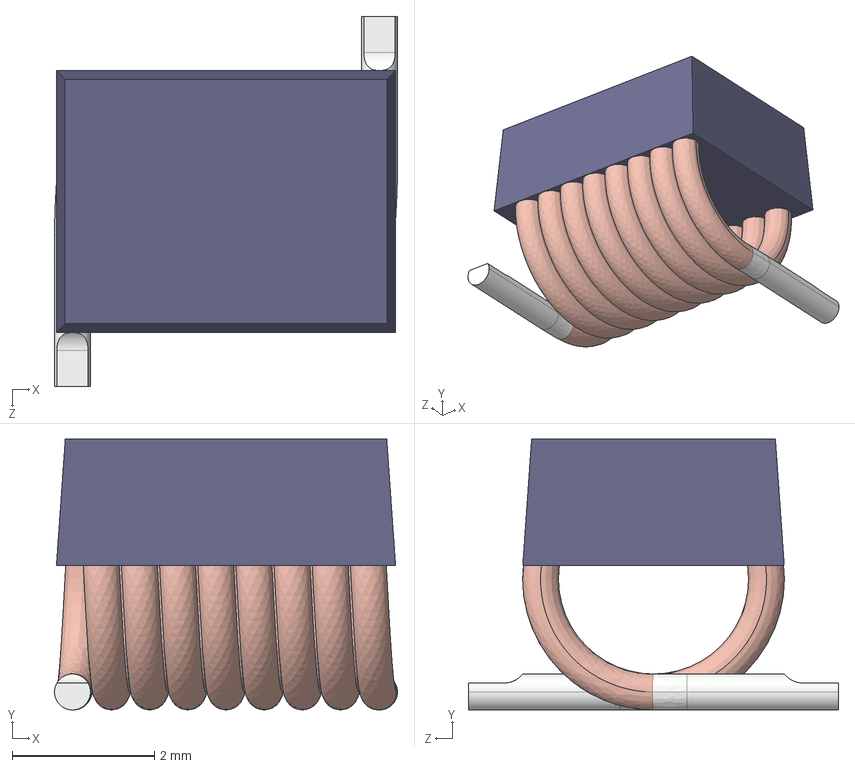
[picture p52: CAD file, 2021-12-20]
3D_Models/Coilcraft/Coilcraft-1812SMS.STEP
4.82 x 3.81 x 5.21 mm
Coilcraft-1812SMS-82N_W XXATZ2-X [1812SMS]_1812SMS-82N_2
Coilcraft-1812SMS-82N_36-625 [T7-566-1]_1812SMS-XXXL_2
