natsfr/kicad-components/3D_Models/ComputeUnit/Rock PI S 3D scan.stp

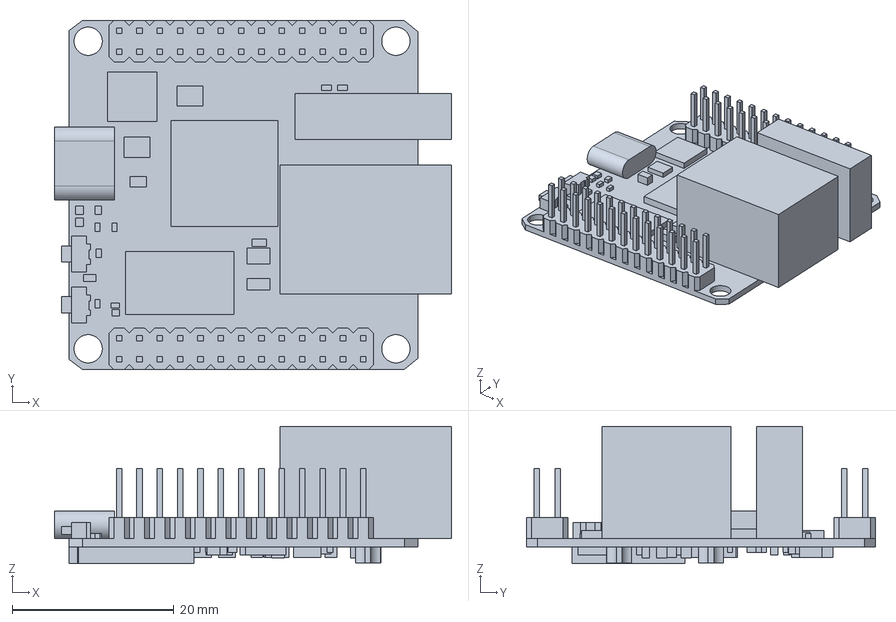
[picture p53: CAD file, 2022-07-30]
3D_Models/ComputeUnit/Rock PI S 3D scan.stp
49.2 x 43.2 x 17.0 mm
