natsfr/kicad-components/3D_Models/Connector_0.8mm/QTE-014-02-F-D-DP-A.stp

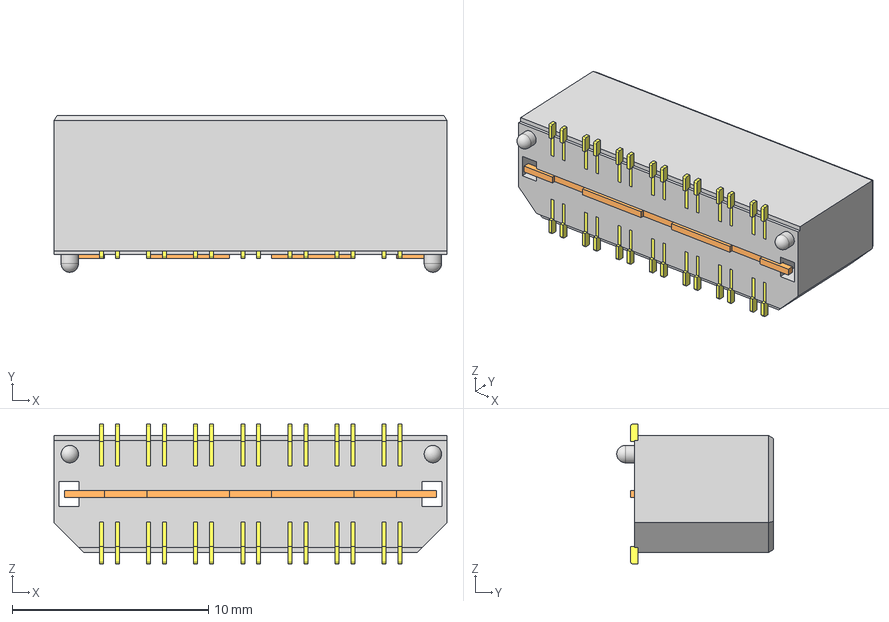
[picture p54: CAD file, 2019-09-05]
3D_Models/Connector_0.8mm/QTE-014-02-F-D-DP-A.stp
20.0 x 7.98 x 7.11 mm
_QTE-014-02-F-D-DP-At
_PT-1S59-02(014-02-D-DP)
_QTE-T-1G1-02_imp
