natsfr/kicad-components/3D_Models/Connector_1.27mm/FLE-110-01-G-DV-A.stp

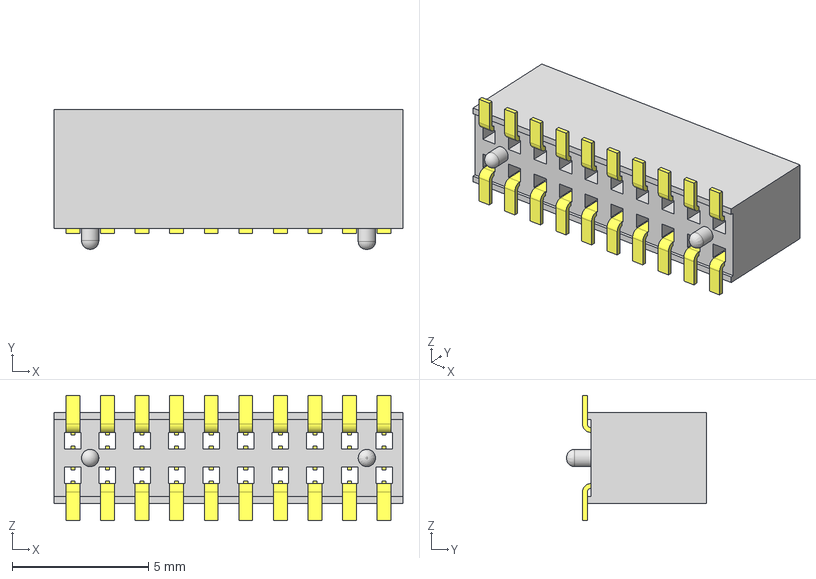
[picture p55: CAD file, 2019-06-12]
3D_Models/Connector_1.27mm/FLE-110-01-G-DV-A.stp
12.8 x 5.13 x 4.59 mm
_FLE-110-01-DV-A_socket
_C-96-01-10-DV
