natsfr/kicad-components/3D_Models/Hirose/HR30-6R-6PD.stp

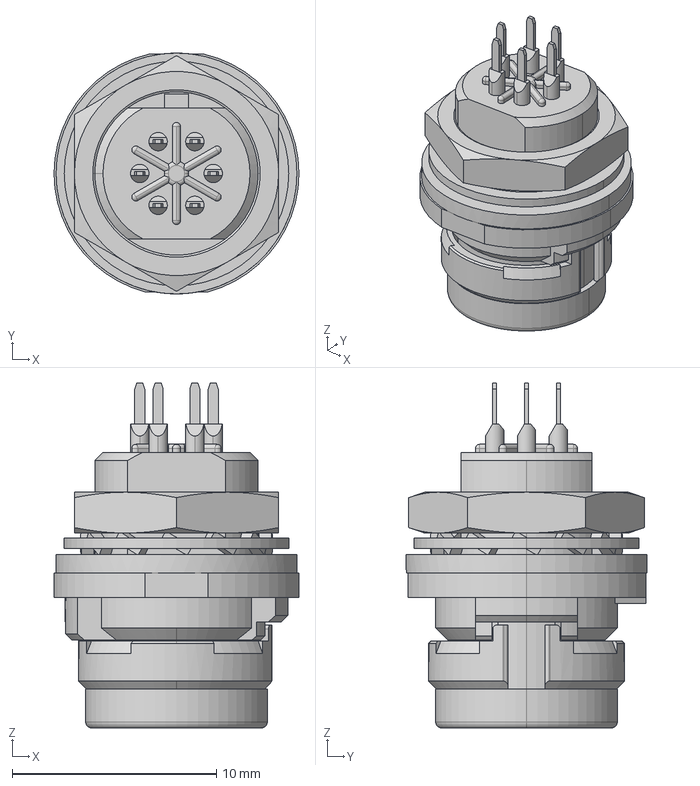
[picture p56: CAD file, 2021-05-31]
3D_Models/Hirose/HR30-6R-6PD.stp
12.0 x 11.8 x 16.9 mm
