natsfr/kicad-components/3D_Models/JST/B2P-VH.stp

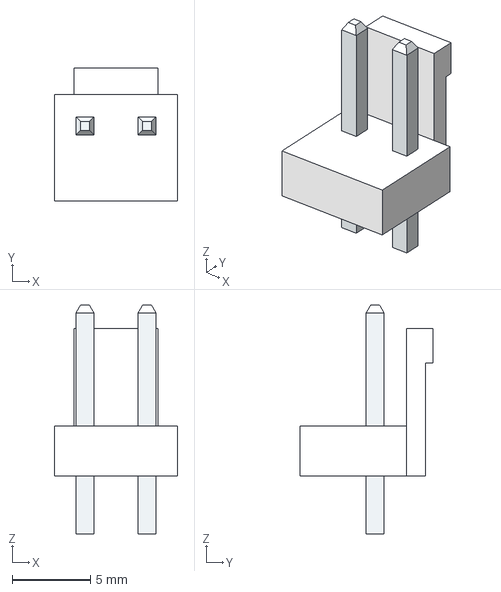
[picture p57: CAD file, 2025-07-04]
3D_Models/JST/B2P-VH.stp
7.86 x 8.50 x 14.6 mm
