natsfr/kicad-components/3D_Models/Laird/bmi-s-209-base.step

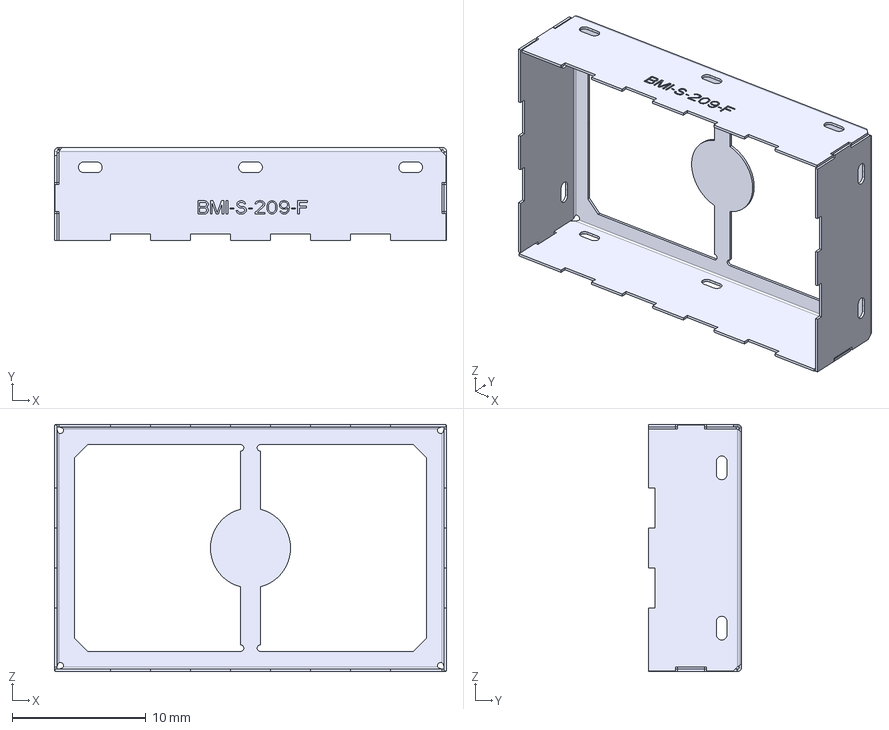
[picture p58: CAD file, 2021-12-20]
3D_Models/Laird/bmi-s-209-base.step
29.4 x 7.00 x 18.5 mm
