natsfr/kicad-components/3D_Models/Lumberg/lumberg_1503_03.stp

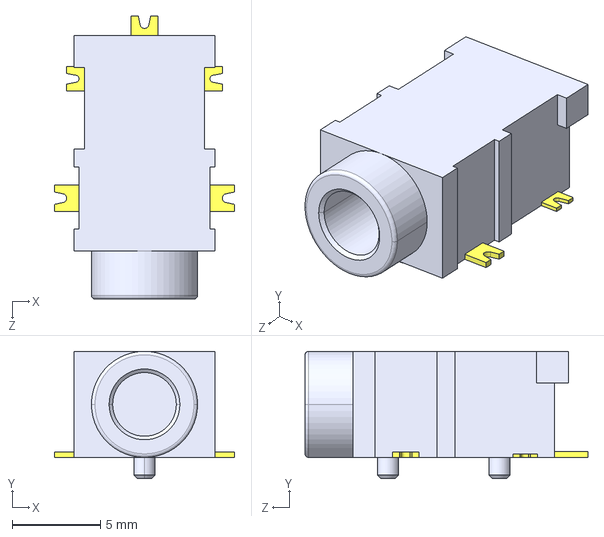
[picture p59: CAD file, 2023-05-27]
3D_Models/Lumberg/lumberg_1503_03.stp
10.2 x 7.20 x 16.0 mm
