natsfr/kicad-components/3D_Models/MiniCircuit/User Library-DF782.STEP

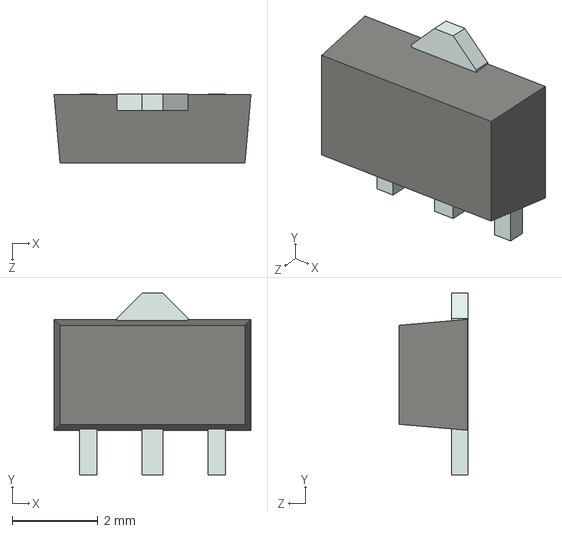
[picture p60: CAD file, 2022-07-30]
3D_Models/MiniCircuit/User Library-DF782.STEP
4.60 x 4.24 x 1.60 mm
