natsfr/kicad-components/3D_Models/Mitsubishi/RA60H3847M1.step

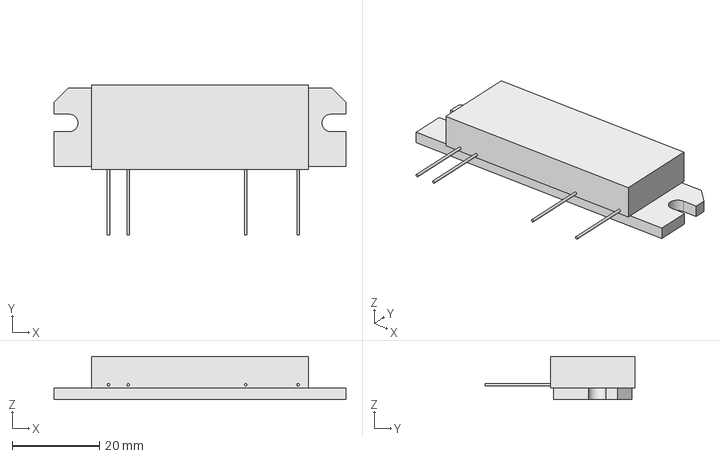
[picture p61: CAD file, 2021-12-28]
3D_Models/Mitsubishi/RA60H3847M1.step
67.0 x 34.4 x 9.90 mm
