natsfr/kicad-components/3D_Models/Omron/D2F_L2_A1.step

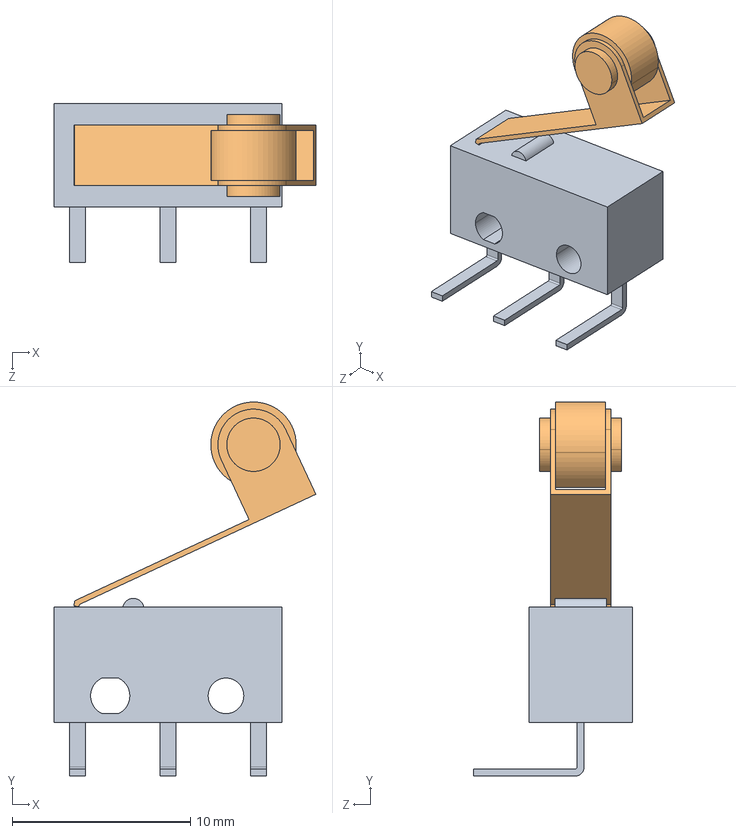
[picture p62: CAD file, 2020-06-26]
3D_Models/Omron/D2F_L2_A1.step
14.7 x 21.0 x 8.90 mm
D2F_L2_A1_BASE
D2F_L2_A1_ACTUATOR
