natsfr/kicad-components/3D_Models/Samtec/QTH-040-01-F-D-DP-RA.stp

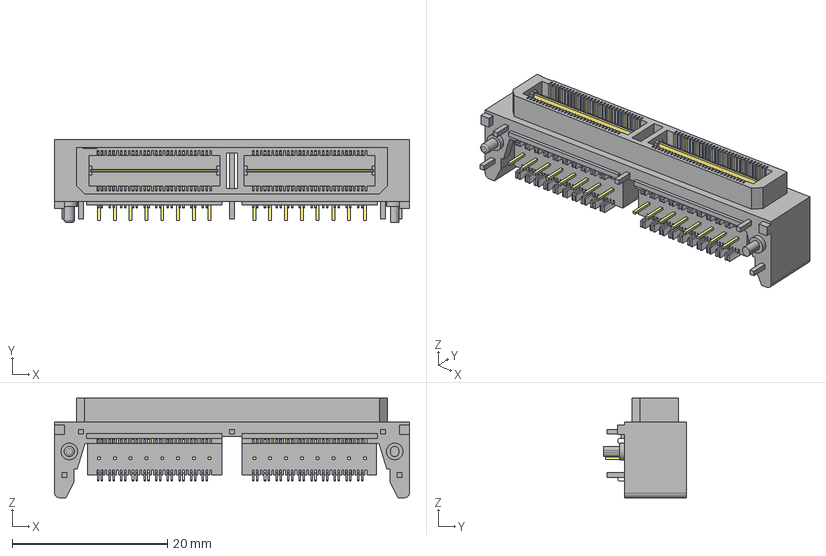
[picture p63: CAD file, 2026-04-20]
3D_Models/Samtec/QTH-040-01-F-D-DP-RA.stp
45.7 x 10.6 x 12.8 mm
QTH-01-060-D-DP-RA_socket
T-1S52-01_pins-1 x 2
T-1S52-01_pins-3 x 2
IM-1G14_pins2 x 2
