natsfr/kicad-components/3D_Models/SOIC/SOIC08 narrow.stp

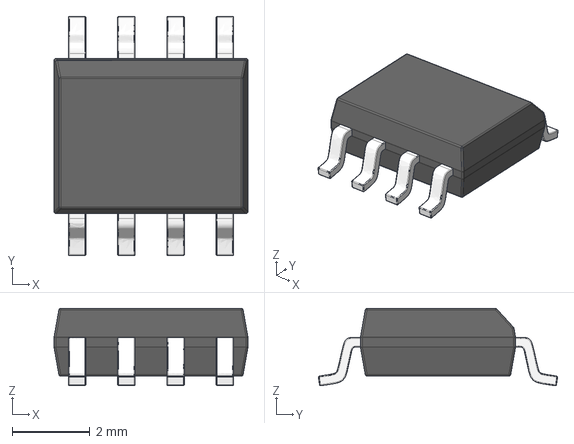
[picture p64: CAD file, 2019-11-22]
3D_Models/SOIC/SOIC08 narrow.stp
5.00 x 6.16 x 2.00 mm
