natsfr/kicad-components/3D_Models/Standard/1206_3.2x1.6x1.6_capacitor.step

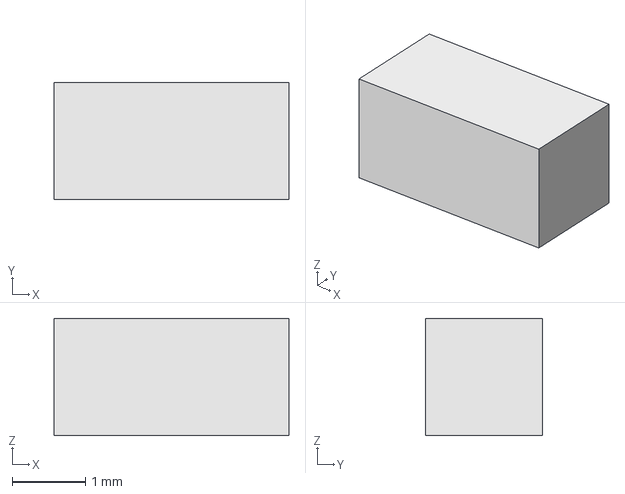
[picture p66: CAD file, 2019-09-25]
3D_Models/Standard/1206_3.2x1.6x1.6_capacitor.step
3.20 x 1.60 x 1.60 mm
