natsfr/kicad-components/3D_Models/TE/c-2129261-1-c-3d.stp

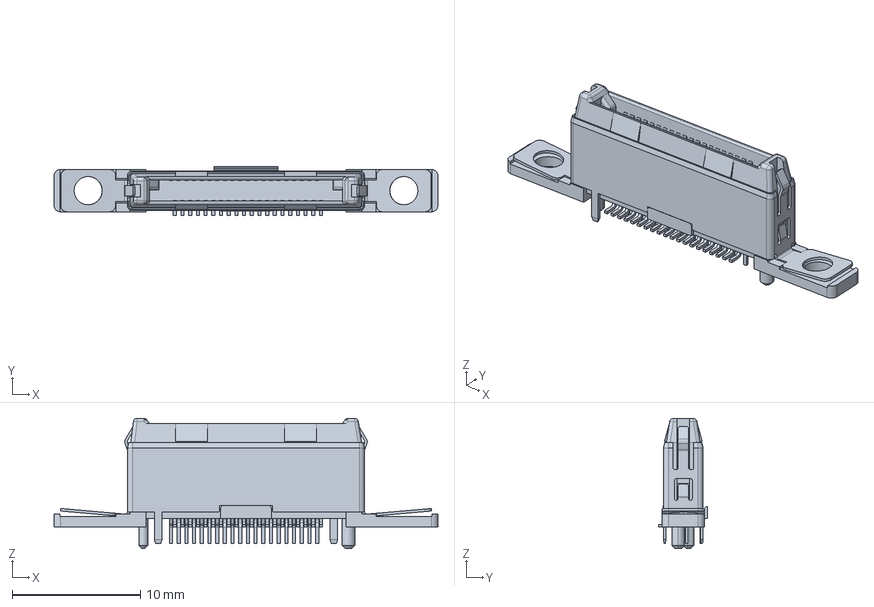
[picture p67: CAD file, 2024-02-25]
3D_Models/TE/c-2129261-1-c-3d.stp
29.9 x 3.81 x 10.2 mm
