natsfr/kicad-components/3D_Models/TI/TPSM84424.stp

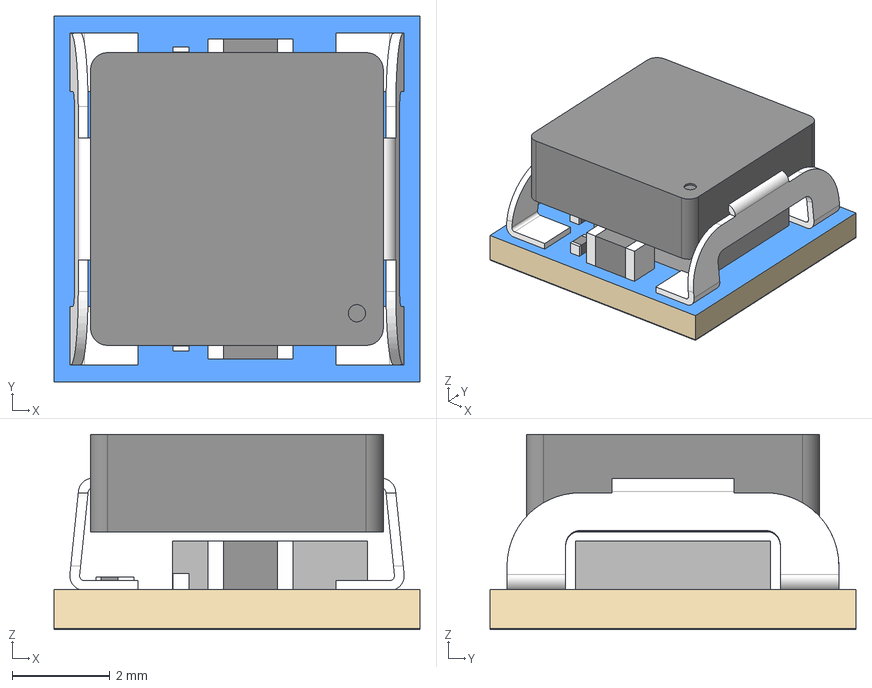
[picture p68: CAD file, 2019-11-14]
3D_Models/TI/TPSM84424.stp
7.50 x 7.50 x 4.01 mm
BOARD
EXTRUDED-452 x 4
EXTRUDED-824 x 2
EXTRUDED-1278 x 2
EXTRUDED-1650
EXTRUDED-2058 x 4
EXTRUDED-2430 x 2
EXTRUDED-2830
1503156784_ASM
MOLD
CLIP x 2
EXTRUDED-8079 x 4
EXTRUDED-8451 x 2
METAL-BTM-QFM
SM-BTM-MOL0024A
PIN1_AREA
