natsfr/kicad-components/3D_Models/Wurth_Ind/STEP_WE-PD_1210_STP_rev1.stp

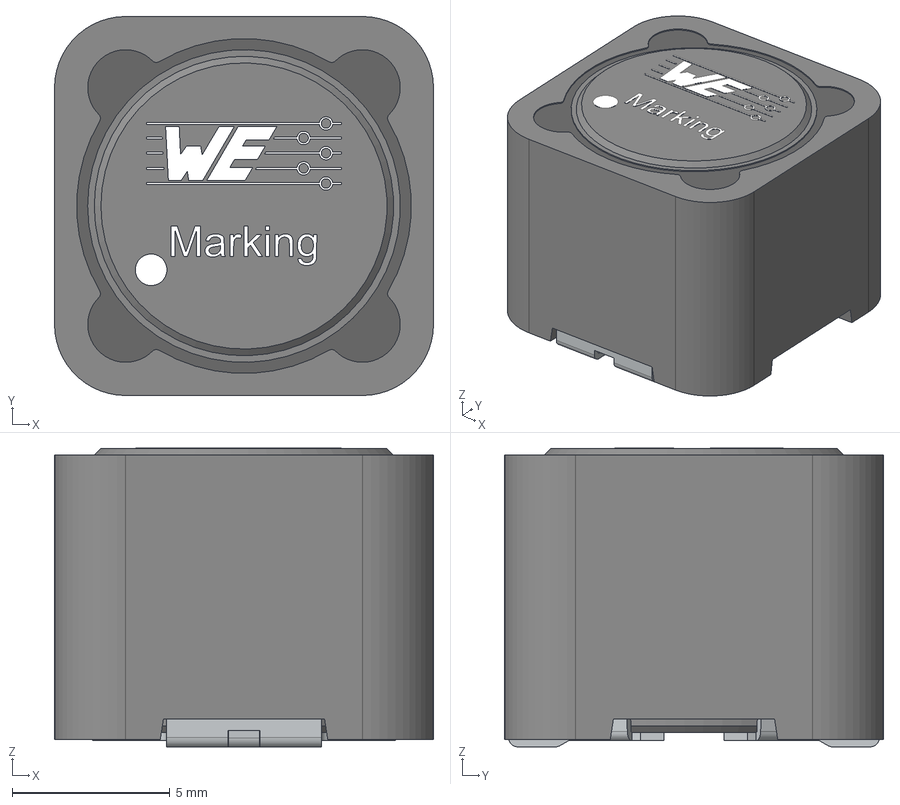
[picture p69: CAD file, 2024-10-08]
3D_Models/Wurth_Ind/STEP_WE-PD_1210_STP_rev1.stp
12.0 x 12.0 x 9.46 mm
Core
ShieldRing
Glue
Leadframe
