natsfr/kicad-components/3D_Models/Amphenol/u.Fl Antenna Connector - 523-A-1JB.STEP

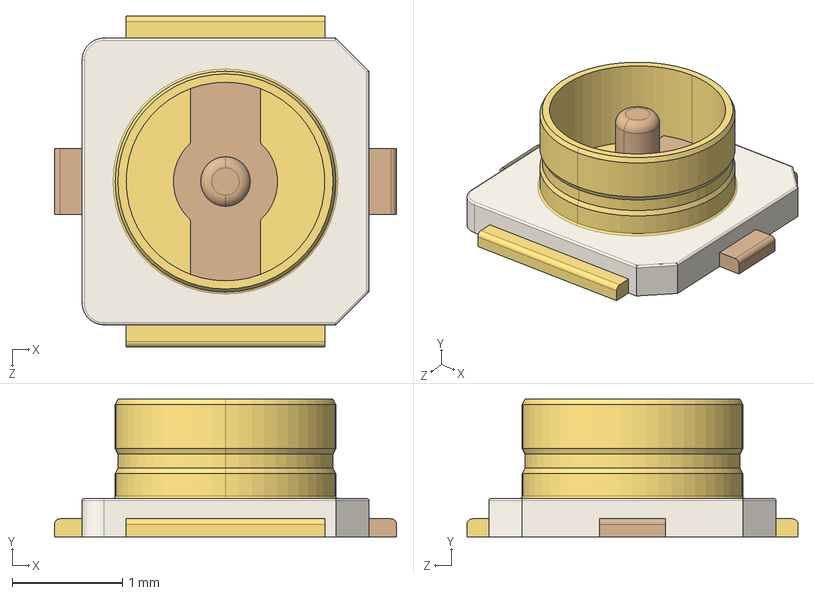
[picture p70: CAD file, 2019-11-22]
3D_Models/Amphenol/u.Fl Antenna Connector - 523-A-1JB.STEP
3.10 x 1.25 x 3.00 mm
