natsfr/kicad-components/3D_Models/Connector_0.8mm/QTE-014-01-F-D-DP-A.stp

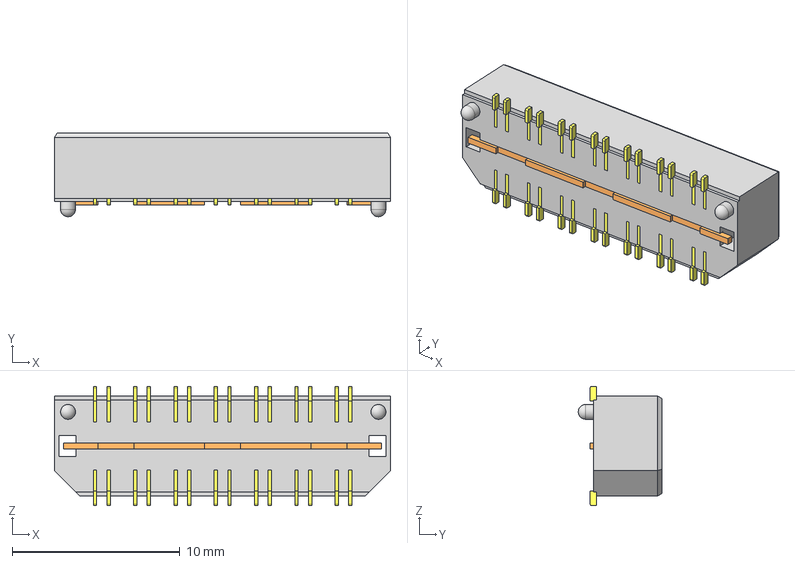
[picture p71: CAD file, 2019-05-28]
3D_Models/Connector_0.8mm/QTE-014-01-F-D-DP-A.stp
20.0 x 4.98 x 7.11 mm
_QTE-014-01-F-D-DP-At
_PT-1S39-01(014-01-D-DP)
_QTE-T-1G1-01_imp
