natsfr/kicad-components/3D_Models/Connector_1.27mm/SFM-110-02-L-D-A.stp

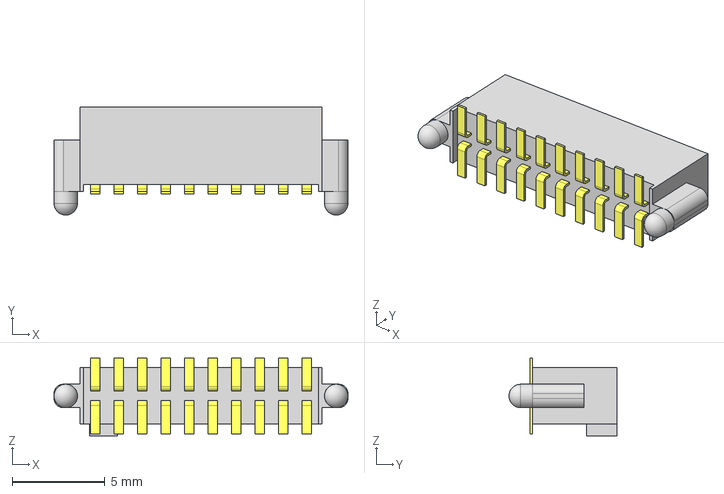
[picture p72: CAD file, 2019-05-29]
3D_Models/Connector_1.27mm/SFM-110-02-L-D-A.stp
15.9 x 5.84 x 4.20 mm
_SFM-110-02-L-D-A_terminal
_C-10-02-D_pins
