natsfr/kicad-components/3D_Models/Connectors_RF/142-0701-881.stp

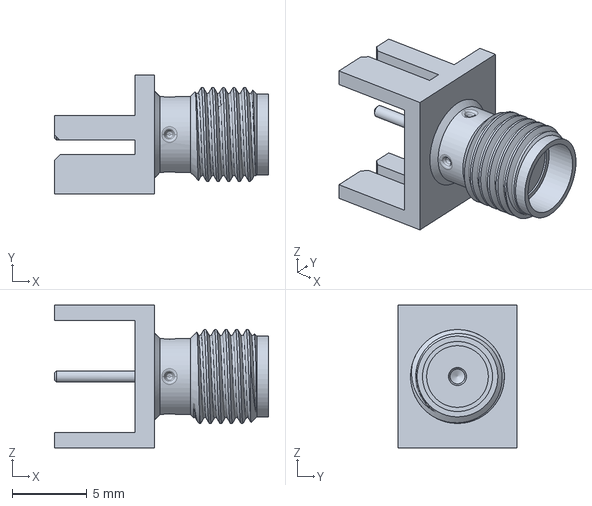
[picture p73: CAD file, 2019-09-26]
3D_Models/Connectors_RF/142-0701-881.stp
14.3 x 7.92 x 9.53 mm
