natsfr/kicad-components/3D_Models/Hirose/HR30-6PA-6S.stp

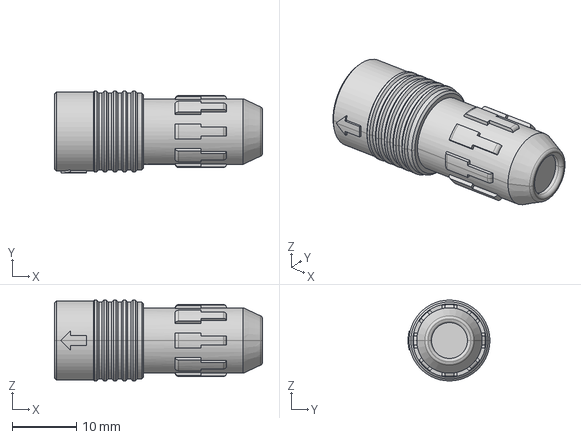
[picture p74: CAD file, 2021-05-31]
3D_Models/Hirose/HR30-6PA-6S.stp
32.4 x 12.8 x 12.6 mm
