natsfr/kicad-components/3D_Models/JST/SM04B-SURS-TF.step

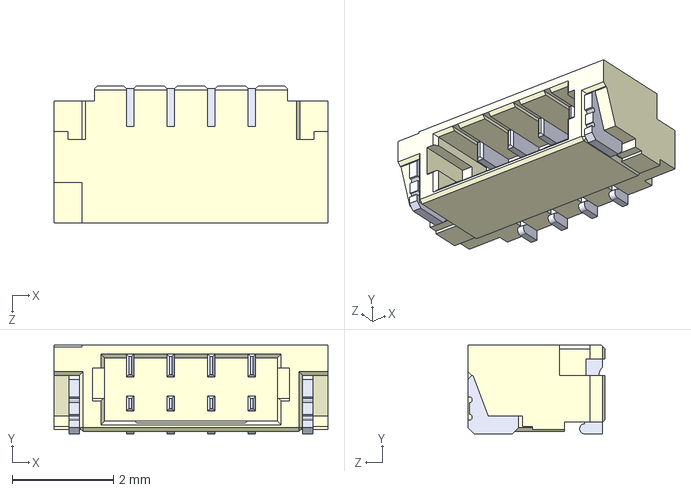
[picture p75: CAD file, 2025-05-12]
3D_Models/JST/SM04B-SURS-TF.step
5.40 x 1.75 x 2.70 mm
