natsfr/kicad-components/3D_Models/MiniCircuit/User Library-CD542.STEP

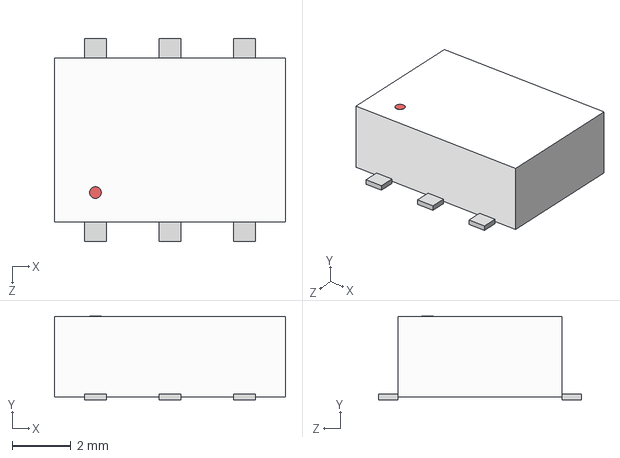
[picture p76: CAD file, 2021-12-20]
3D_Models/MiniCircuit/User Library-CD542.STEP
7.87 x 2.85 x 6.91 mm
