natsfr/kicad-components/3D_Models/SOIC/SOIC16 narrow.stp

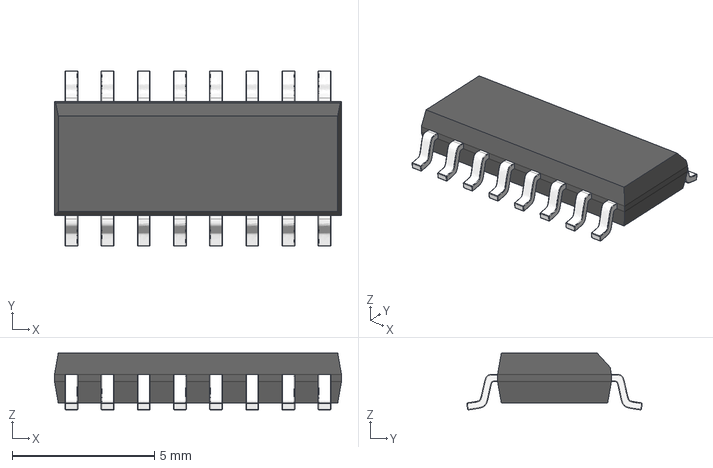
[picture p78: CAD file, 2019-11-22]
3D_Models/SOIC/SOIC16 narrow.stp
10.1 x 6.16 x 2.00 mm
