natsfr/kicad-components/3D_Models/Standard/0603_1.6x0.8x0.45_resistor.step

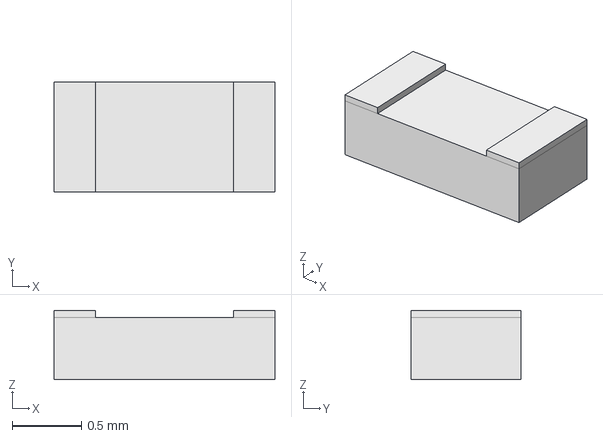
[picture p80: CAD file, 2019-05-17]
3D_Models/Standard/0603_1.6x0.8x0.45_resistor.step
1.60 x 0.8 x 0.5 mm
