natsfr/kicad-components/3D_Models/TE/c-2129260-1-b-3d.stp

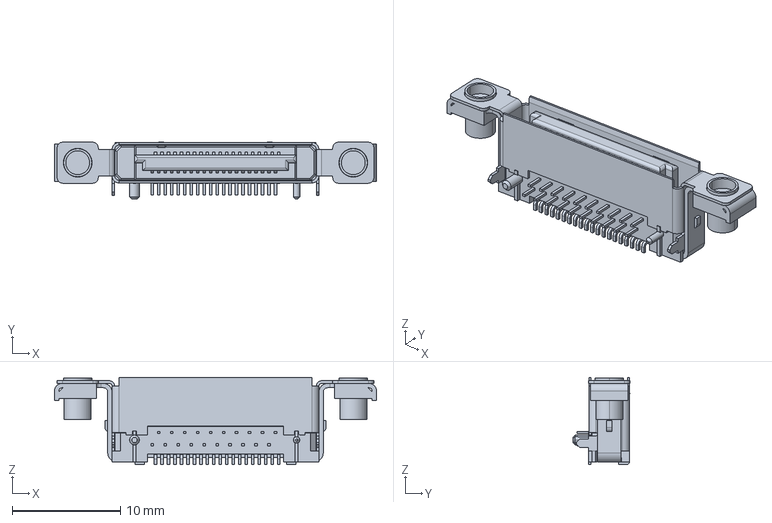
[picture p81: CAD file, 2024-02-25]
3D_Models/TE/c-2129260-1-b-3d.stp
29.8 x 5.31 x 8.05 mm
