natsfr/kicad-components/3D_Models/Wurth_Ind/STP_WE-LHMI-8030.stp

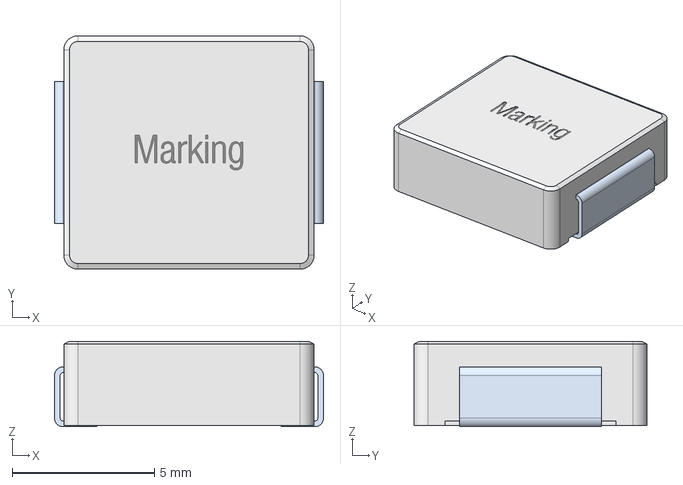
[picture p82: CAD file, 2021-12-20]
3D_Models/Wurth_Ind/STP_WE-LHMI-8030.stp
9.45 x 8.20 x 3.00 mm
base
pin
