natsfr/kicad-components/3D_Models/Basic/2.05x1.65x0.6mm.step

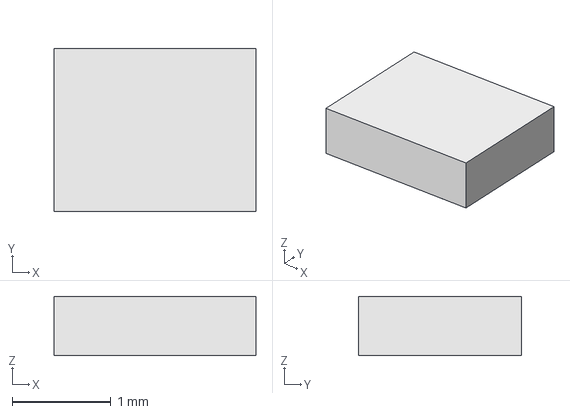
[picture p83: CAD file, 2024-11-25]
3D_Models/Basic/2.05x1.65x0.6mm.step
2.05 x 1.65 x 0.6 mm
