natsfr/kicad-components/3D_Models/Connector_0.8mm/QSE-014-01-F-D-DP-A.stp

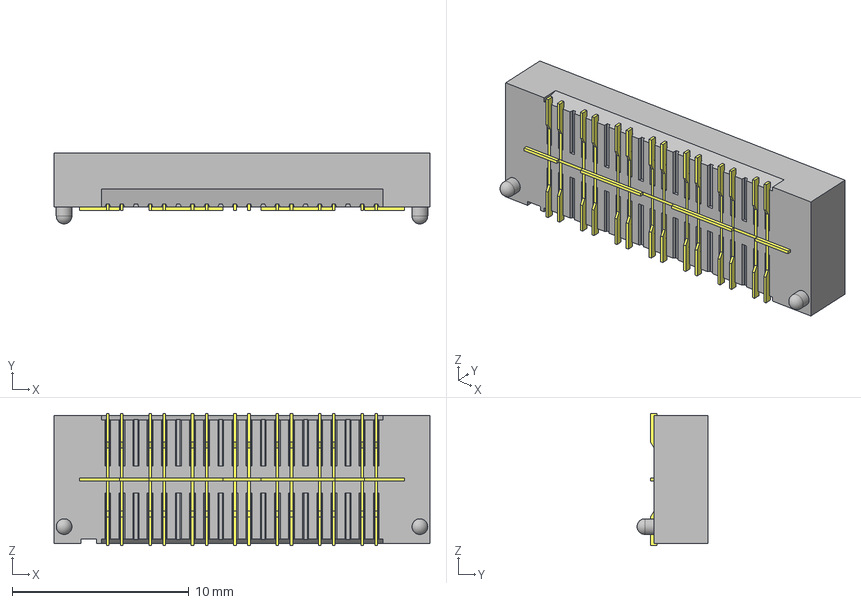
[picture p84: CAD file, 2019-05-24]
3D_Models/Connector_0.8mm/QSE-014-01-F-D-DP-A.stp
21.3 x 4.01 x 7.49 mm
_QSE-014-01-F-D-DP-A_terminal
_QSE-T-1G2-01-014
_QSE-C-126-21-014-D-DP-D
