natsfr/kicad-components/3D_Models/Connector_1.27mm/TFM-110-01-L-D-A.stp

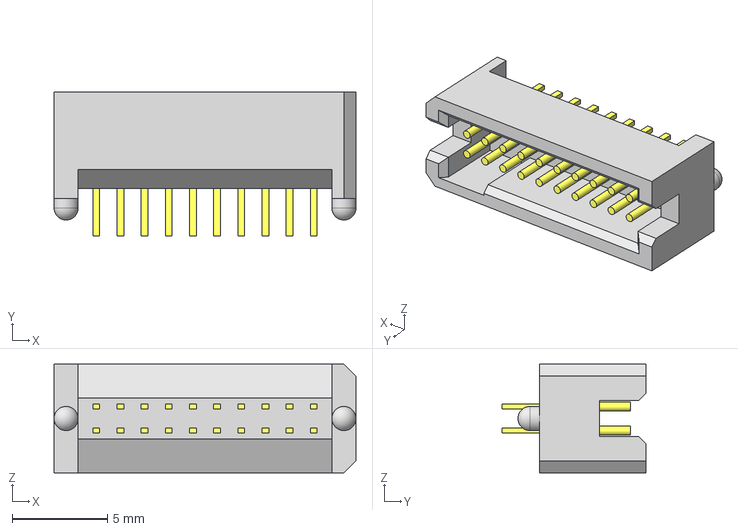
[picture p85: CAD file, 2019-05-29]
3D_Models/Connector_1.27mm/TFM-110-01-L-D-A.stp
15.9 x 7.57 x 5.71 mm
_TFM-110-01-L-D-A_terminal
_TFM-110-01-L-D_pins
