natsfr/kicad-components/3D_Models/MiniCircuit/User Library-RLM 751.STEP

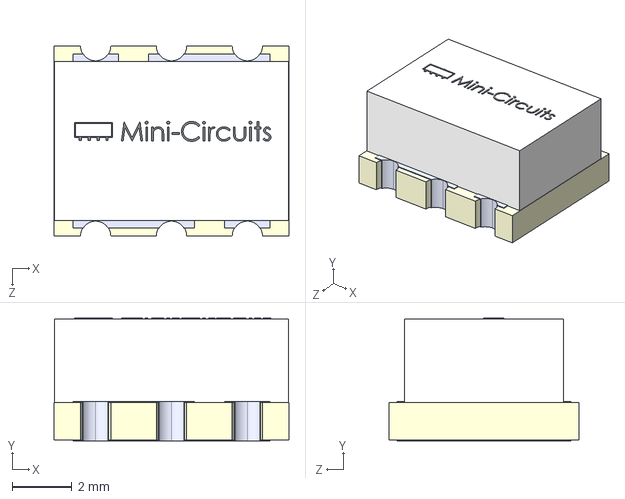
[picture p86: CAD file, 2019-11-22]
3D_Models/MiniCircuit/User Library-RLM 751.STEP
7.87 x 4.11 x 6.35 mm
