natsfr/kicad-components/3D_Models/Samtec/QTH-040-02-L-D-DP-A-K-TR.stp

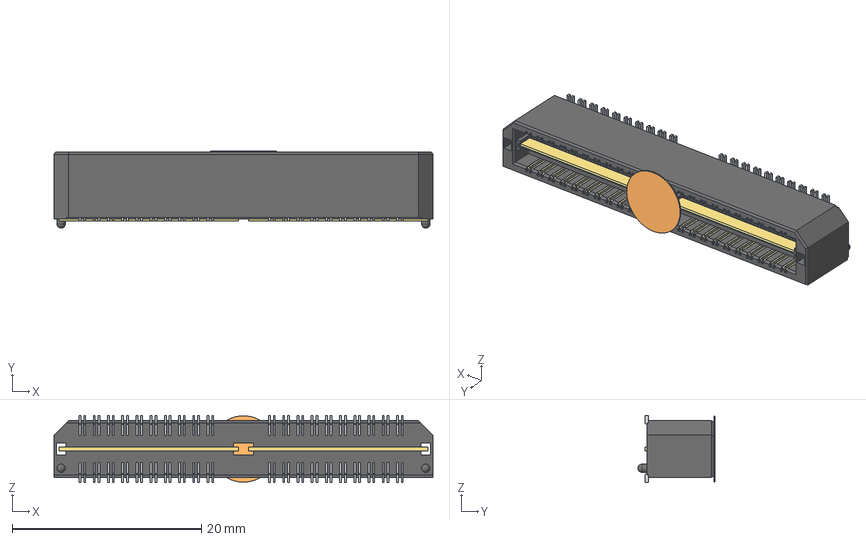
[picture p87: CAD file, 2025-06-12]
3D_Models/Samtec/QTH-040-02-L-D-DP-A-K-TR.stp
40.0 x 8.16 x 7.11 mm
TQTH-040-02-L-D-DP-A-K-TR_terminal
T-1S59-02(-040-02-D-DP-L)_pin x 2
T-1S59-02(-040-02-D-DP)_pin2 x 2
T-1G1-02_imp x 2
QTH-Kapton_pad
