natsfr/kicad-components/3D_Models/SOIC/SOIC14 narrow.stp

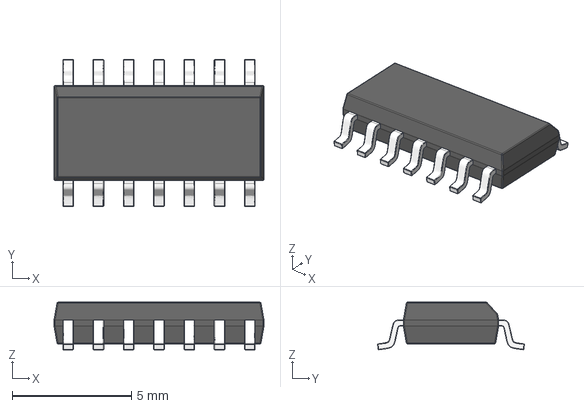
[picture p88: CAD file, 2019-11-22]
3D_Models/SOIC/SOIC14 narrow.stp
8.81 x 6.16 x 2.00 mm
