natsfr/kicad-components/3D_Models/Standard/0402_1x0.5x0.35_resistor.step

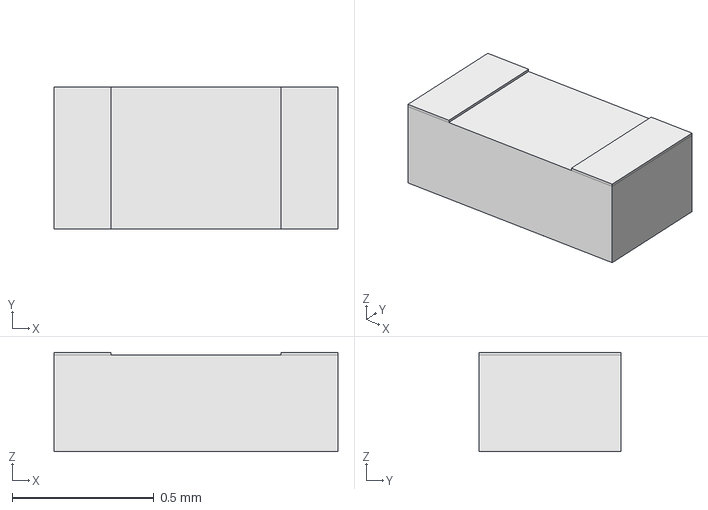
[picture p89: CAD file, 2019-03-14]
3D_Models/Standard/0402_1x0.5x0.35_resistor.step
1.00 x 0.5 x 0.35 mm
