natsfr/kicad-components/3D_Models/TE/c-4-1734592-0-c-3d.stp

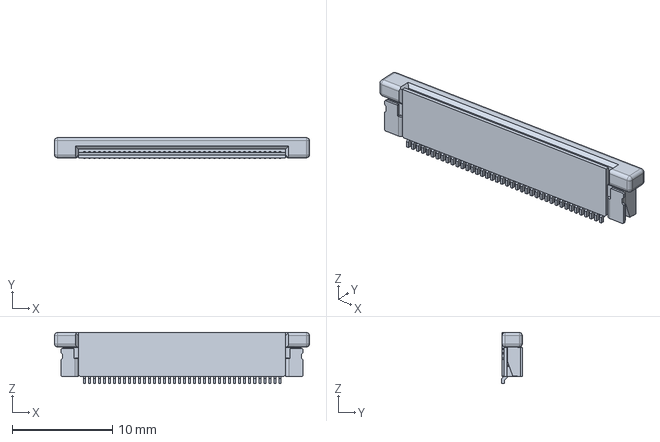
[picture p90: CAD file, 2023-07-08]
3D_Models/TE/c-4-1734592-0-c-3d.stp
25.4 x 2.05 x 5.11 mm
