natsfr/kicad-components/3D_Models/Wurth_Con/Stand_9774110360_11mm.stp

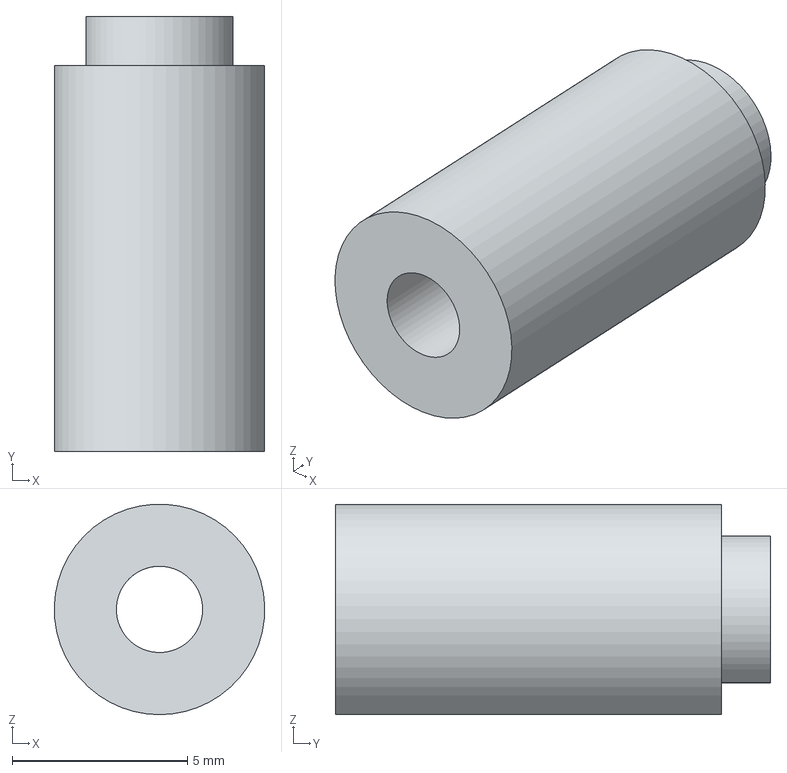
[picture p91: CAD file, 2021-07-12]
3D_Models/Wurth_Con/Stand_9774110360_11mm.stp
6.00 x 12.4 x 5.99 mm
