natsfr/kicad-components/3D_Models/Wurth_Ind/STEP-WE-TPC-1038-rev1.stp

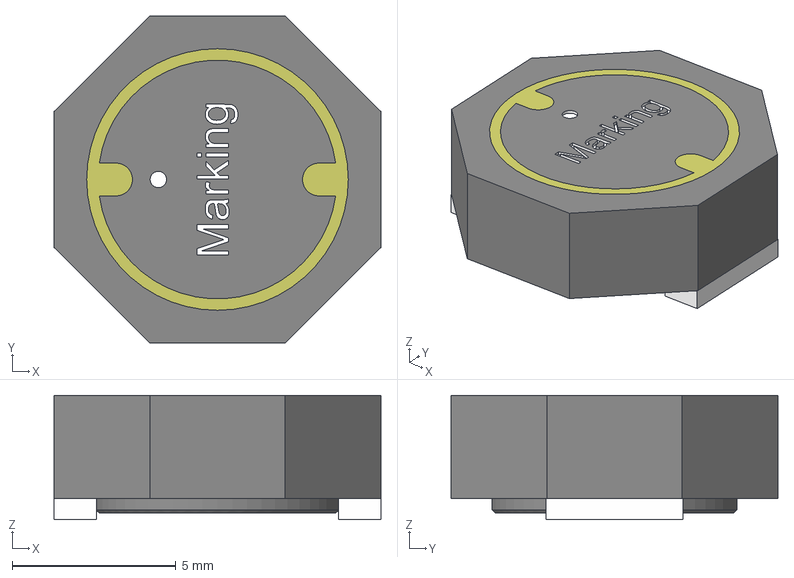
[picture p92: CAD file, 2019-05-28]
3D_Models/Wurth_Ind/STEP-WE-TPC-1038-rev1.stp
10.0 x 10.00 x 3.80 mm
