natsfr/kicad-components/3D_Models/Connector_0.8mm/FTE-130-01-G-DV.stp

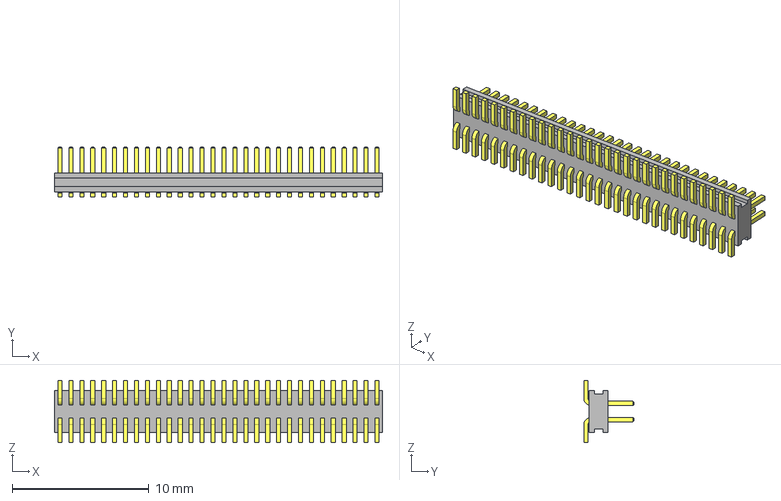
[picture p93: CAD file, 2019-05-24]
3D_Models/Connector_0.8mm/FTE-130-01-G-DV.stp
24.0 x 3.68 x 4.57 mm
_FTE-130-01-G-DV_body
_FTE-130-01-G-DV_pins
