natsfr/kicad-components/3D_Models/Samtec/FTSH-105-01-L-DV-K.stp

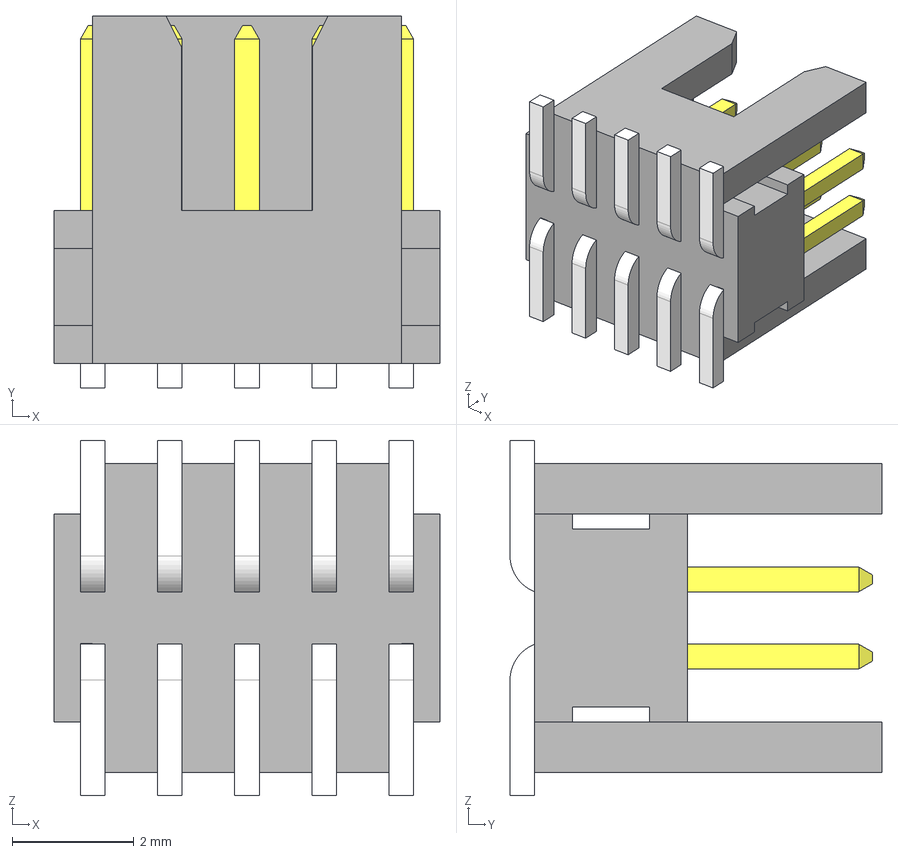
[picture p94: CAD file, 2023-09-03]
3D_Models/Samtec/FTSH-105-01-L-DV-K.stp
6.35 x 6.12 x 5.84 mm
FTSH-105-01-L-DV-K_pins2
FTSH-105-01-L-DV-K_pins1
FTSH-105-01-L-DV-K_body
