natsfr/kicad-components/3D_Models/SOIC/SOIC10 narrow.stp

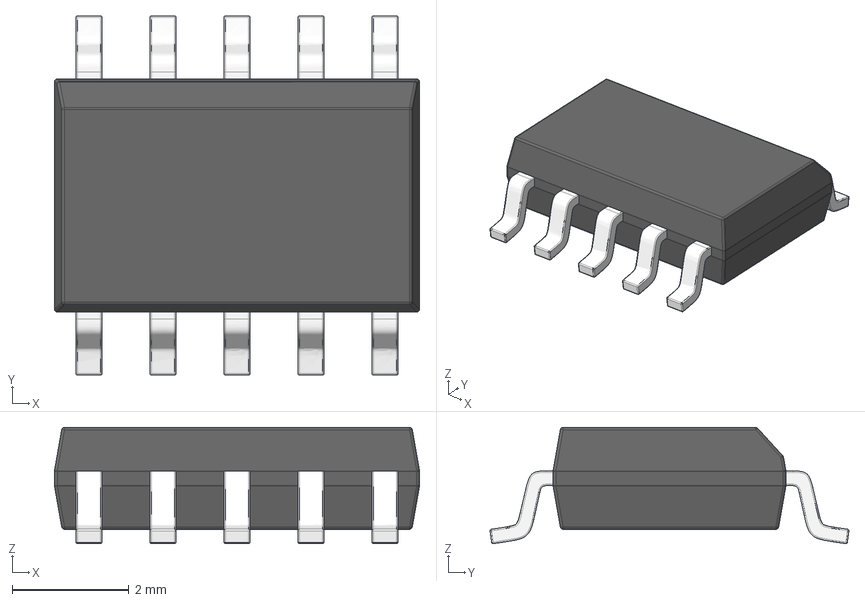
[picture p95: CAD file, 2019-11-22]
3D_Models/SOIC/SOIC10 narrow.stp
6.27 x 6.16 x 2.00 mm
