natsfr/kicad-components/3D_Models/TE/SMA_Vertical_5-1814832-1.stp

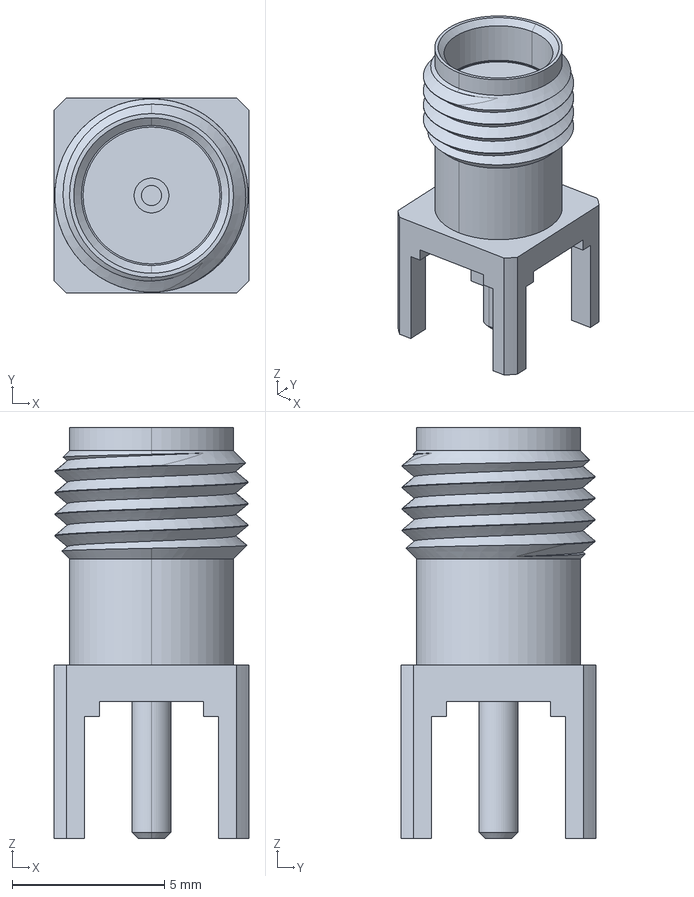
[picture p96: CAD file, 2022-01-17]
3D_Models/TE/SMA_Vertical_5-1814832-1.stp
6.40 x 6.40 x 13.5 mm
