natsfr/kicad-components/3D_Models/Basic/3.2x2.5x1.2mm.step

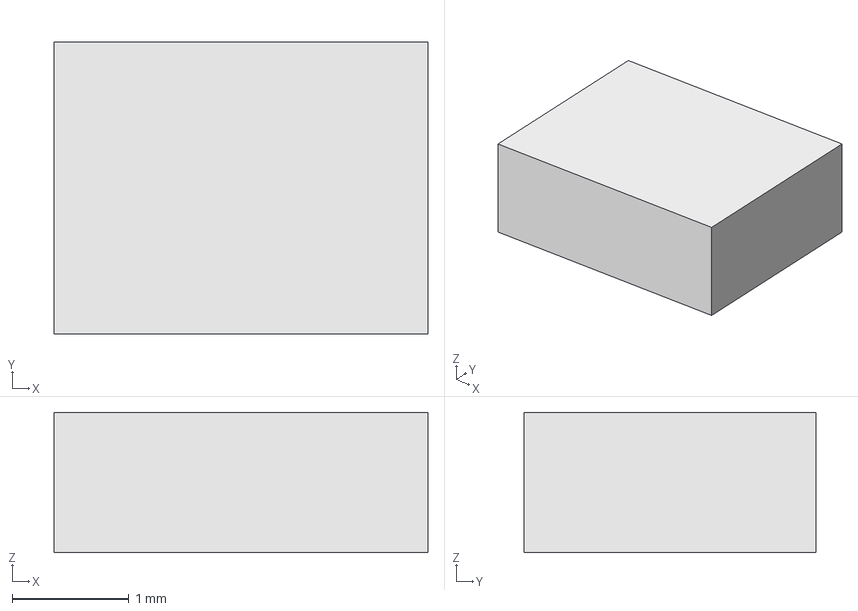
[picture p97: CAD file, 2023-07-08]
3D_Models/Basic/3.2x2.5x1.2mm.step
3.20 x 2.50 x 1.20 mm
