natsfr/kicad-components/3D_Models/Connector_0.8mm/Antelec_AM2D_DI_S_80_60_2.5-12.3_G.FCStd

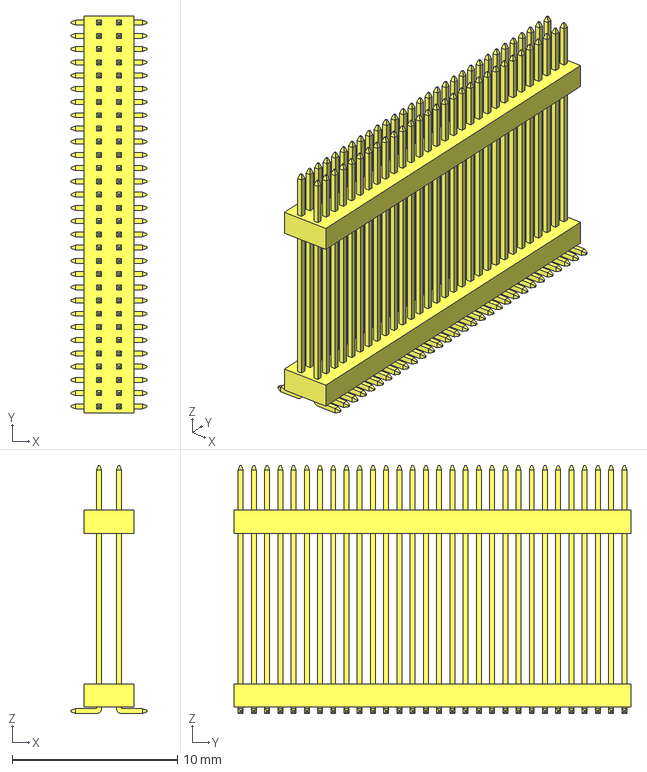
[picture p98: CAD file, 2019-05-17]
3D_Models/Connector_0.8mm/Antelec_AM2D_DI_S_80_60_2.5-12.3_G.FCStd
4.57 x 24.0 x 15.0 mm
