natsfr/kicad-components/3D_Models/Samtec/IPL1-104-01-L-S-RA-K.stp

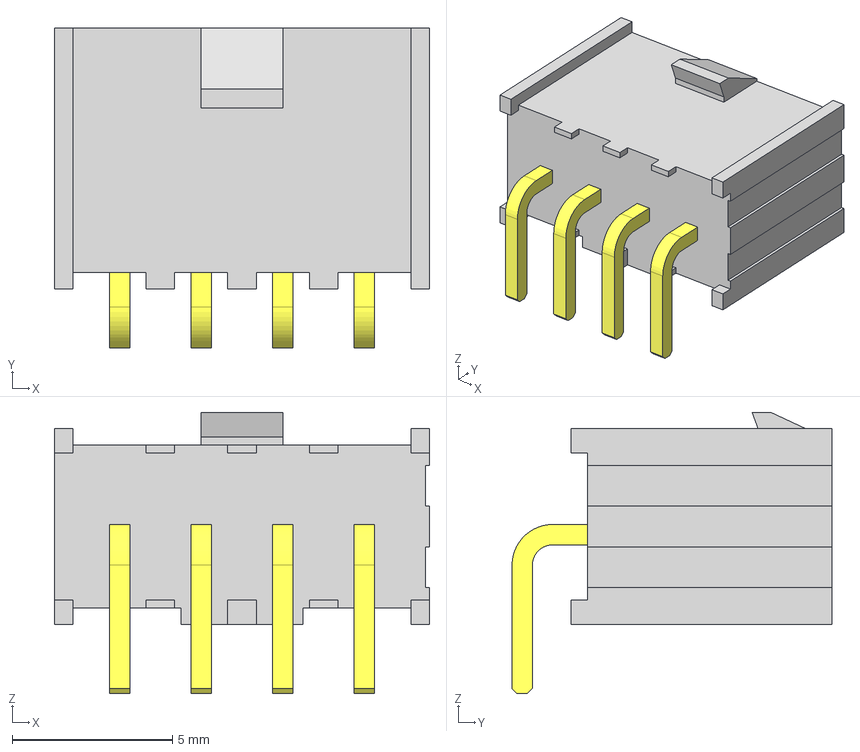
[picture p99: CAD file, 2020-06-26]
3D_Models/Samtec/IPL1-104-01-L-S-RA-K.stp
11.7 x 9.97 x 8.76 mm
_IPL1-104-01-S-RA-K_HDR
_T-1S64-01-04-S-RA
