natsfr/kicad-components/3D_Models/TE/c-2118716-2-a-3d.stp

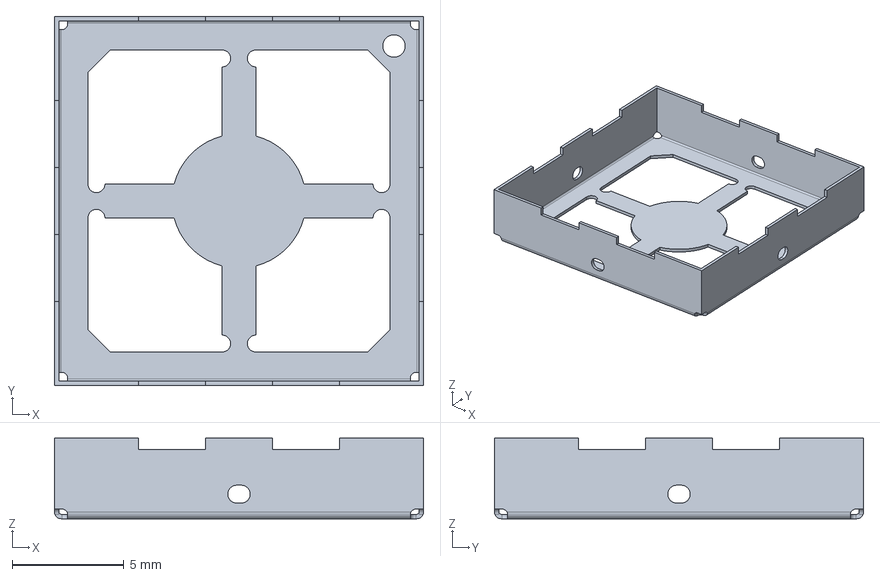
[picture p100: CAD file, 2021-12-20]
3D_Models/TE/c-2118716-2-a-3d.stp
16.5 x 16.5 x 3.60 mm
