natsfr/kicad-components/3D_Models/Basic/3x3x1mm.step

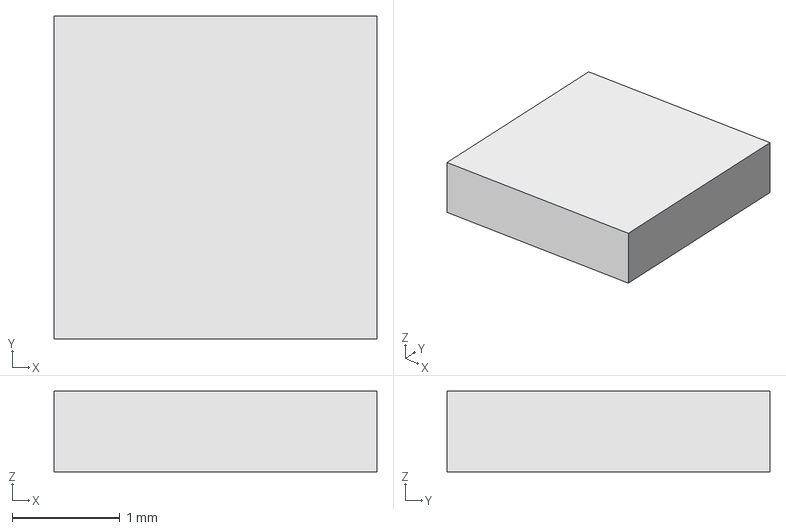
[picture p101: CAD file, 2023-07-08]
3D_Models/Basic/3x3x1mm.step
3.00 x 3.00 x 0.75 mm
