natsfr/kicad-components/3D_Models/TE/IM06GR.stp

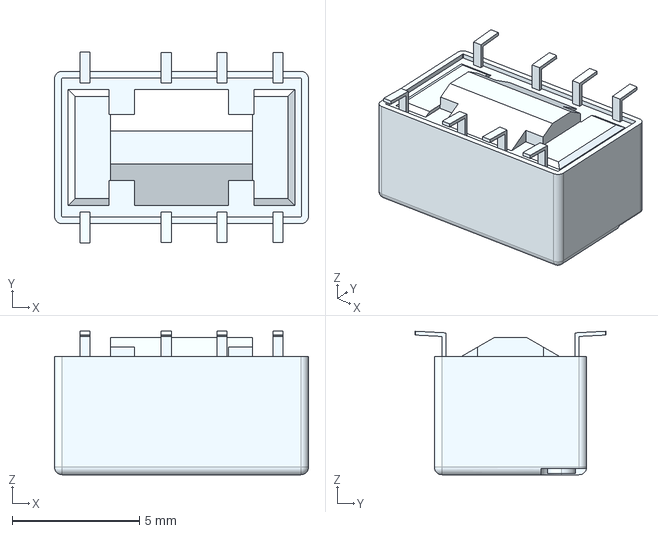
[picture p102: CAD file, 2020-07-24]
3D_Models/TE/IM06GR.stp
10.0 x 7.52 x 5.65 mm
