natsfr/kicad-components/3D_Models/Basic/9x9x1mm.step

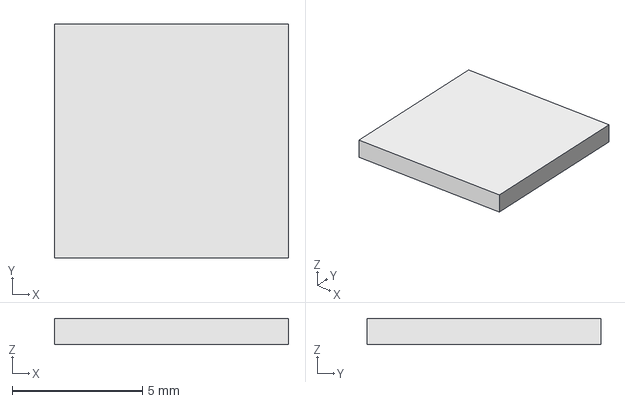
[picture p103: CAD file, 2023-05-27]
3D_Models/Basic/9x9x1mm.step
9.00 x 9.00 x 1.00 mm
