natsfr/kicad-components/3D_Models/TE/IM06JR.stp

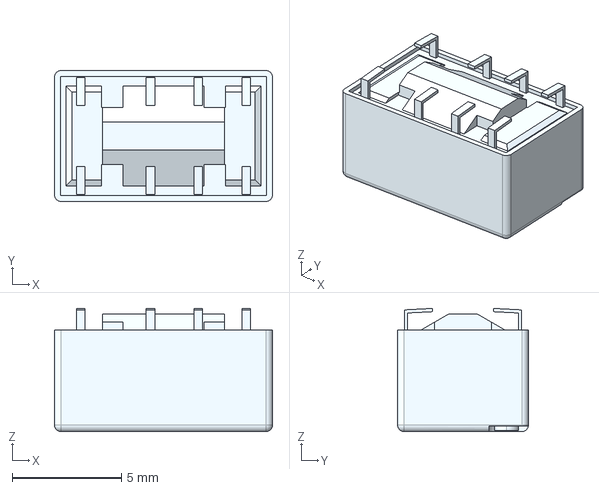
[picture p104: CAD file, 2020-07-24]
3D_Models/TE/IM06JR.stp
10.0 x 6.00 x 5.65 mm
