natsfr/kicad-components/3D_Models/Basic/cylinder_28.6_12.7.step

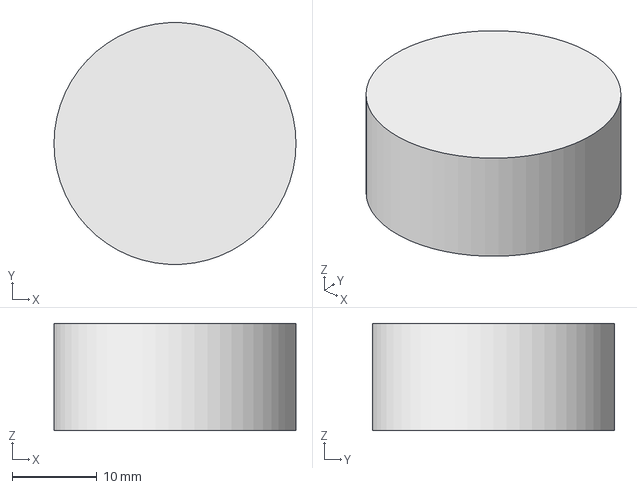
[picture p105: CAD file, 2020-06-26]
3D_Models/Basic/cylinder_28.6_12.7.step
28.6 x 28.6 x 12.7 mm
