natsfr/kicad-components/3D_Models/TE/c-726388-2-e-3d.stp

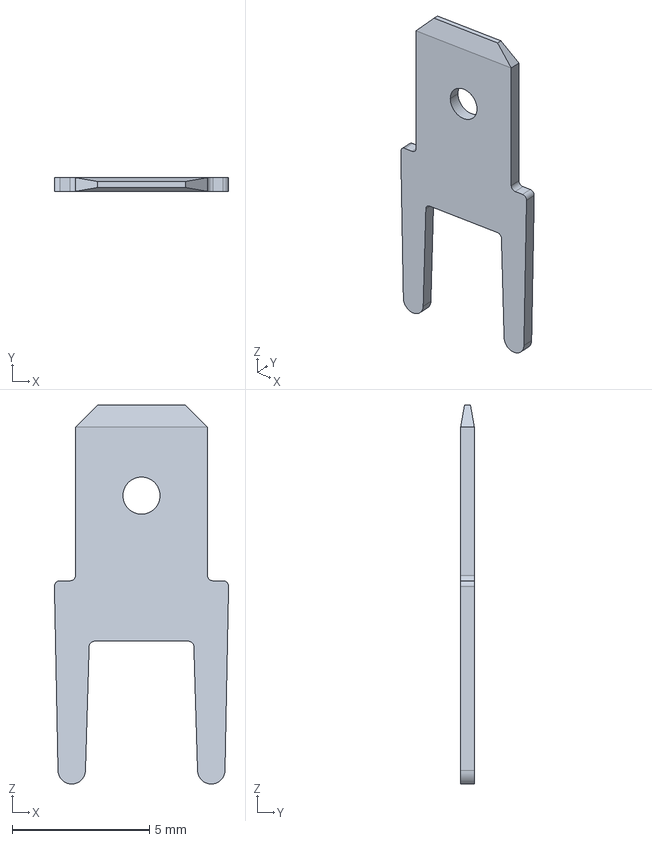
[picture p106: CAD file, 2020-06-26]
3D_Models/TE/c-726388-2-e-3d.stp
6.34 x 0.5 x 13.8 mm
