natsfr/kicad-components/3D_Models/Basic/4x4x0.75mm.step

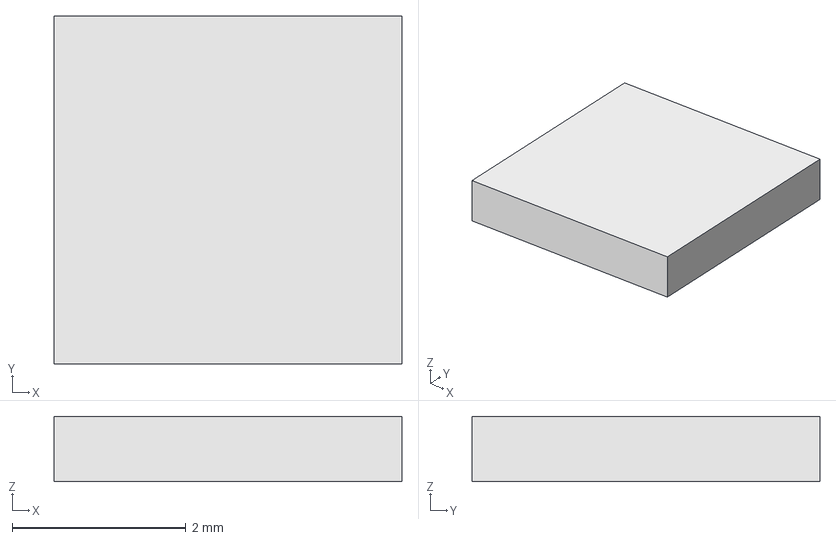
[picture p107: CAD file, 2019-10-08]
3D_Models/Basic/4x4x0.75mm.step
4.00 x 4.00 x 0.75 mm
