natsfr/kicad-components/3D_Models/TE/c-2294415-1-c-3d.stp

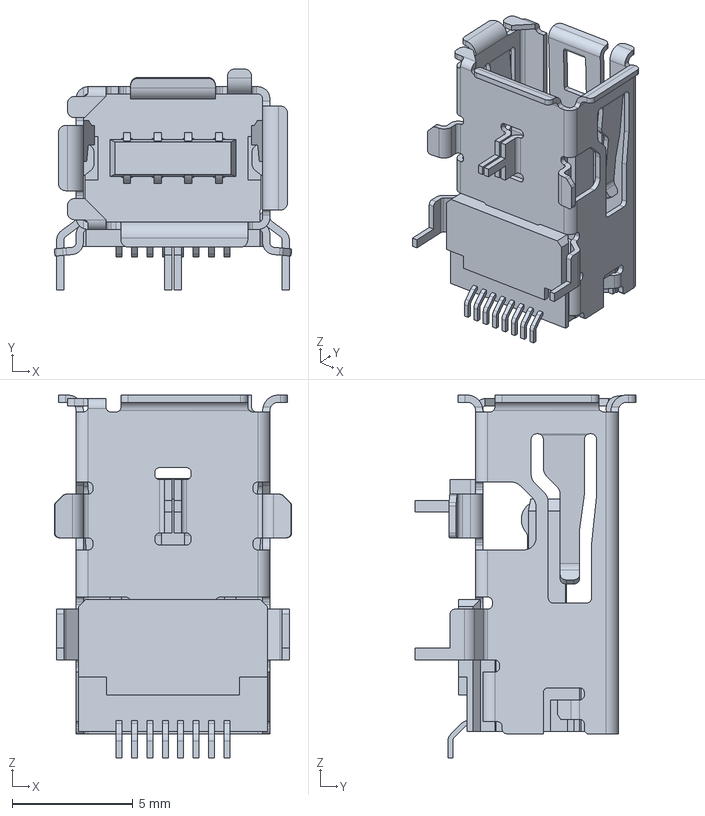
[picture p108: CAD file, 2019-06-25]
3D_Models/TE/c-2294415-1-c-3d.stp
9.81 x 9.13 x 15.0 mm
