natsfr/kicad-components/3D_Models/Basic/2x2.5x0.75mm.step

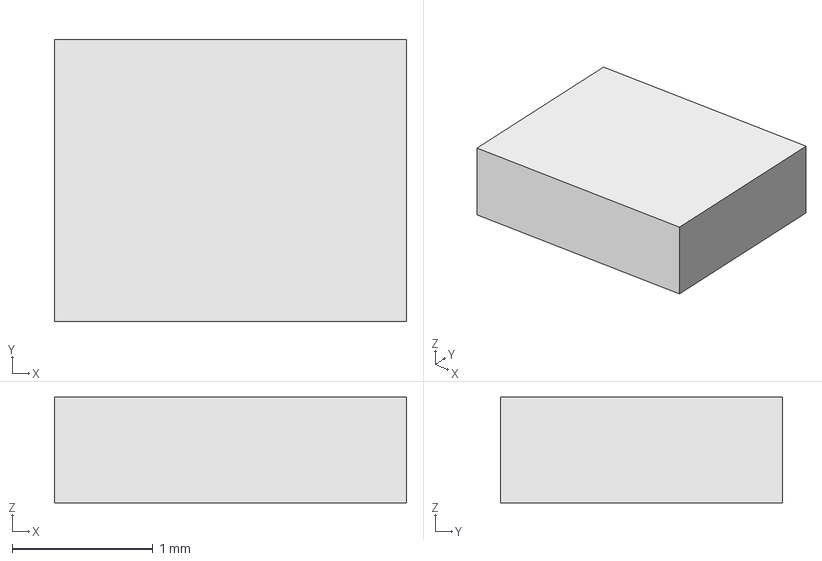
[picture p109: CAD file, 2019-10-08]
3D_Models/Basic/2x2.5x0.75mm.step
2.50 x 2.00 x 0.75 mm
