natsfr/kicad-components/3D_Models/Molex/Molex_Mirco_USB_105017-0001.step

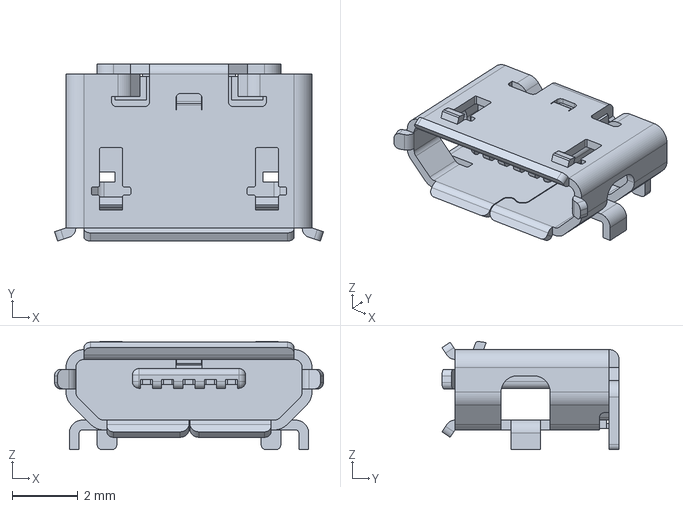
[picture p110: CAD file, 2021-10-07]
3D_Models/Molex/Molex_Mirco_USB_105017-0001.step
8.20 x 5.40 x 3.30 mm
