natsfr/kicad-components/3D_Models/Basic/3.5x2.5x1mm.step

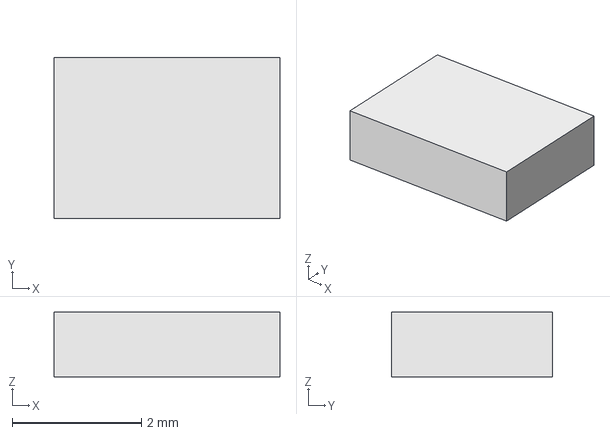
[picture p112: CAD file, 2019-10-08]
3D_Models/Basic/3.5x2.5x1mm.step
3.50 x 2.50 x 1.00 mm
