natsfr/kicad-components/3D_Models/Molex/SMA_73100-0115.STEP

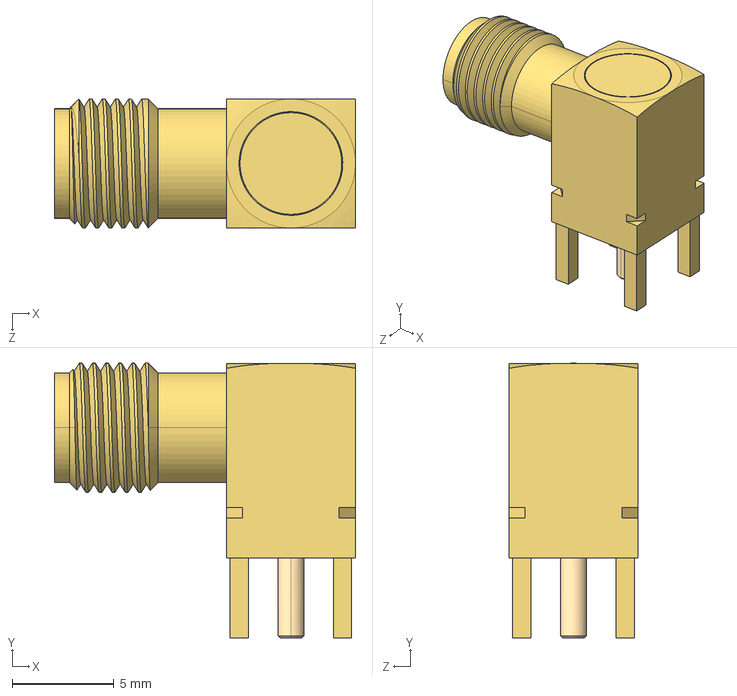
[picture p113: CAD file, 2021-05-31]
3D_Models/Molex/SMA_73100-0115.STEP
14.8 x 13.5 x 6.35 mm
