natsfr/kicad-components/3D_Models/Basic/2x2x0.75mm.step

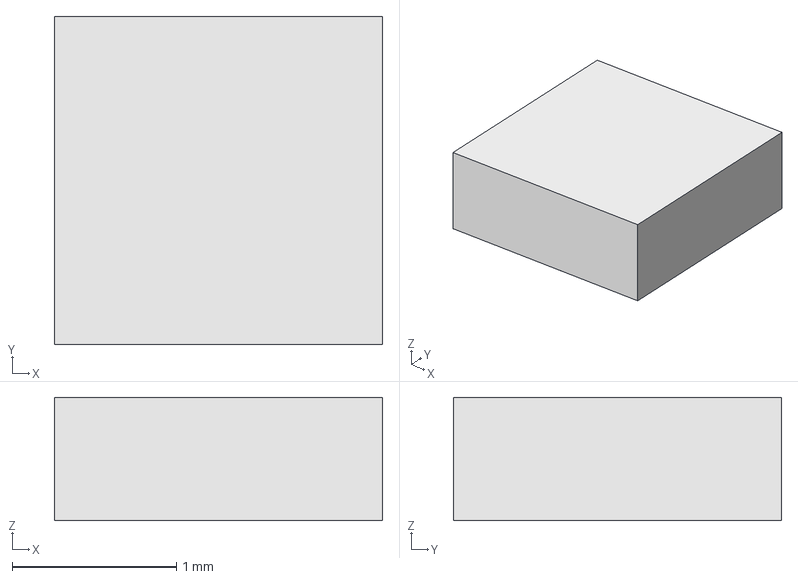
[picture p114: CAD file, 2019-09-26]
3D_Models/Basic/2x2x0.75mm.step
2.00 x 2.00 x 0.75 mm
