natsfr/kicad-components/3D_Models/Basic/2.8x2.9x1mm.step

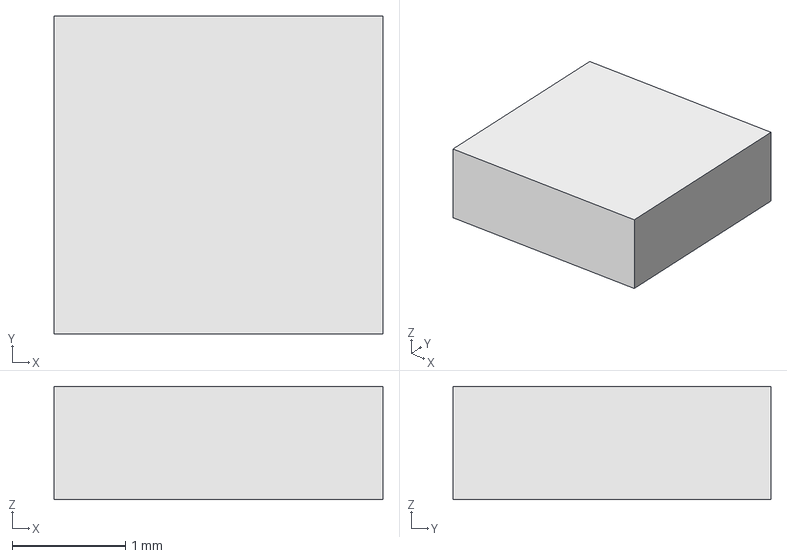
[picture p115: CAD file, 2019-05-17]
3D_Models/Basic/2.8x2.9x1mm.step
2.90 x 2.80 x 1.00 mm
