natsfr/kicad-components/3D_Models/Basic/0.8x1.6x0.8mm.step

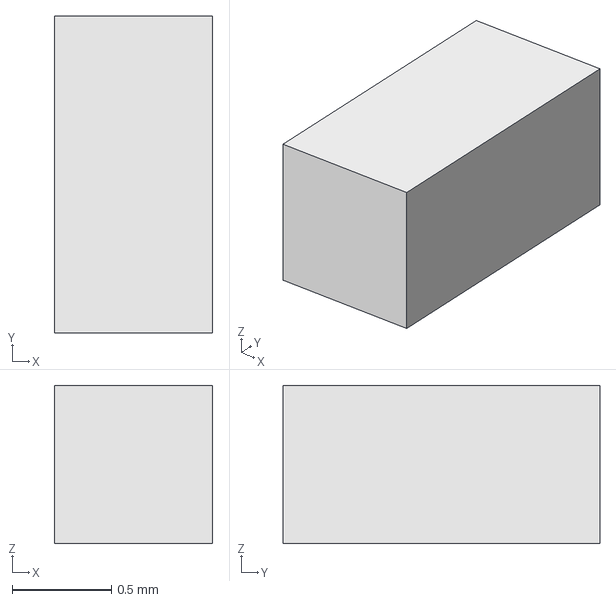
[picture p116: CAD file, 2019-05-17]
3D_Models/Basic/0.8x1.6x0.8mm.step
0.8 x 1.60 x 0.8 mm
