natsfr/kicad-components/3D_Models/Basic/3.6x3.4x2.step

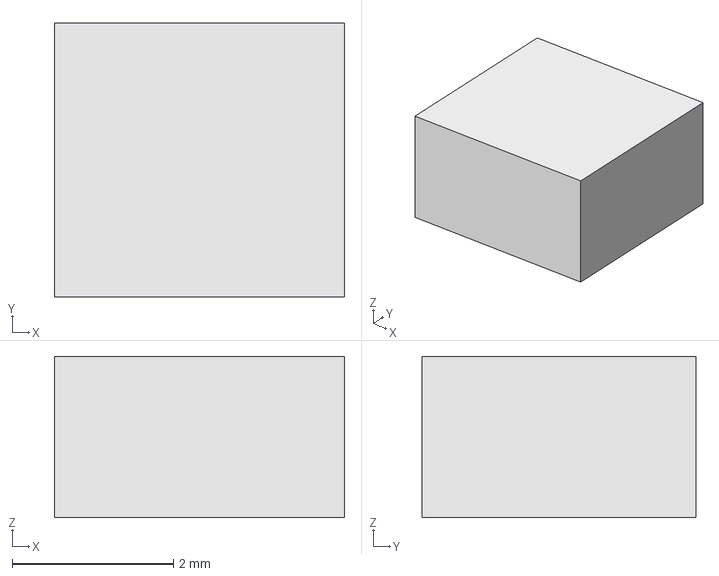
[picture p117: CAD file, 2019-03-14]
3D_Models/Basic/3.6x3.4x2.step
3.60 x 3.40 x 2.00 mm
