natsfr/kicad-components/3D_Models/Basic/24.5x3x15.step

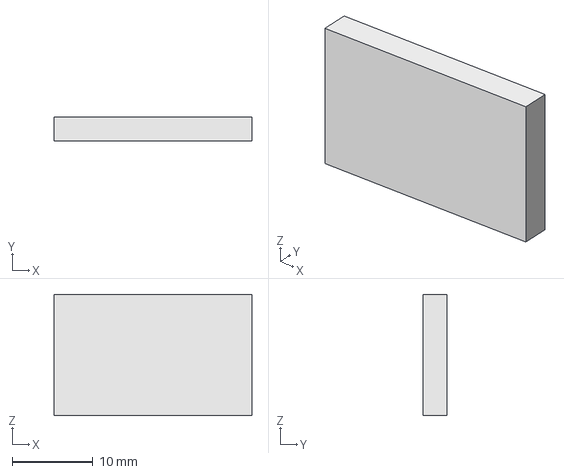
[picture p118: CAD file, 2019-03-14]
3D_Models/Basic/24.5x3x15.step
24.5 x 3.00 x 15.0 mm
