natsfr/kicad-components/3D_Models/Basic/4.9x3x1.18mm.step

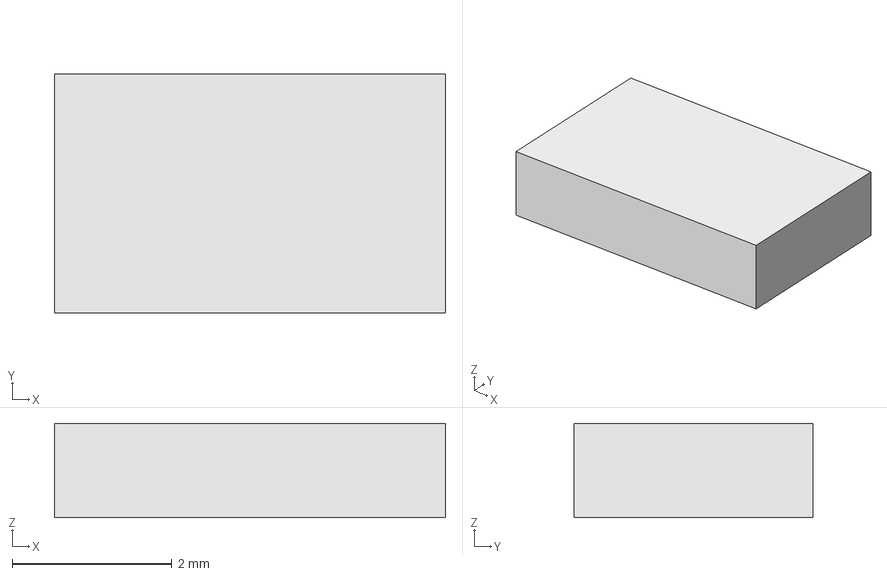
[picture p119: CAD file, 2019-03-14]
3D_Models/Basic/4.9x3x1.18mm.step
4.90 x 3.00 x 1.18 mm
