natsfr/kicad-components/(list of files, cad)

Other CAD files:
3D_Models/Connectors_RF/142-0701-841.stp
3D_Models/SOT/SOT23-4.stp
3D_Models/Amphenol/54602-908LFc.stp
3D_Models/BGA/BC-144-7_0.8mm_10x10x1.3mm.FCStd
3D_Models/Bergstak/61082-041400LF.stp
3D_Models/Bergstak/61082-042402LF.stp
3D_Models/Bergstak/61083-043400LF.stp
3D_Models/Bergstak/61083-044000.stp
3D_Models/Bourns/PT61018PEL.STEP
3D_Models/Harting/09452812560_100695473MOD000D.STP
3D_Models/Harwin/m50-3801042_asm.stp
3D_Models/Mitsubishi/RA60H3847M1.FCStd
3D_Models/Molex/0705430002.stp
3D_Models/Molex/1054051106.stp
3D_Models/Molex/2004850740.stp
3D_Models/Molex/2121340002.stp
3D_Models/Molex/436500303.stp
3D_Models/Molex/436500403.stp
3D_Models/Molex/470531000.stp
3D_Models/Molex/559320410.stp
3D_Models/Molex/559320610.stp
3D_Models/Molex/559320810.stp
3D_Models/Molex/878325623.stp
3D_Models/Molex/955522887.stp
3D_Models/Panasonic_connectors/ayf530435-closed.step
3D_Models/Panasonic_connectors/ayf530835-closed.step
3D_Models/Standard/0402_1x0.5x0.35_resistor.FCStd
3D_Models/Standard/0603_1.6x0.8x0.45_resistor.FCStd
3D_Models/Wurth_Con/629105150521_USB.stp
3D_Models/Wurth_Con/691322310016.stp
3D_Models/Wurth_Con/692221030100_USB3.stp
3D_Models/Wurth_Con/7498111124.stp
