natsfr/kicad-components/python_plugins/simple.kicad_pcb

## KiCad design python_plugins/simple.kicad_pcb (2016-04-14)

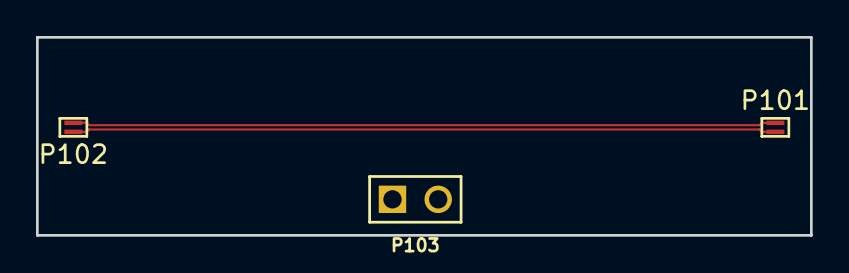
[picture p120: board simple.kicad_pcb from above]

Board: 2 copper layers, 43.0 x 11.0 mm, 3 parts (0 on the bottom side), 3 nets.

Parts:
P101, P102: CONN_01X02; TEST_01x02_05mm
P103: CONN_01X02; pin_array_2x1

Connections:
/HS_N: P101.2, P102.1
/HS_P: P101.1, P102.2
GND: P103.1, P103.2
