natsfr/kicad-components/(commit log)

2010-10-11 Added Pic18F2xK20 schematic
2010-10-11 Added XC9572XL Schematic (vqfp44, pc44) and VQFP44 Footprint
2010-10-11 Added Maxim DS1077 Osc and NS LM2734 Buck converter.
2011-03-09 Added Microchip TC105 buck converter
2012-07-23 Add MP2562DS SOIC8 schematic
2012-07-23 Add uSD-Card connector and hanrun magjack
2013-10-24 Added Silabs Si446x schematic and STM32F103RG schematic
2015-02-02 added xtals resistors and drv88(
2015-02-04 added lm27313, reg113, stm32f103tb
2015-02-20 corrected si44-x schematic | added more fixed package capacitor and inductor
2015-02-22 added xtal and modification stm32f103tb
2015-02-24 added first pretty kicad module
2015-02-25 adding qfn plugin for kicad
2015-02-26 silkscreen bug + IO file error
2015-03-02 works with the help of pcbnew_easy.py need to think about integrating it
2015-03-05 added older power symbol for compatibility
2015-03-15 added a bunch of footprints
2015-04-13 add max4389 amplifier and BGA256 footprint
2015-04-17 added sexy footprint
2015-04-17 added sma footprint
2015-04-20 added jtag arm connector + corrected some qfn footprint
2015-04-21 added GND pad connection on qfn
2015-08-03 added SI1102 + mounting hole
2015-08-09 Adding SST25 (generic spi flash)
2015-08-09 adding 0402/SOIC8/DM3CS footprints
2015-08-11 add AS213-92 rf switch symbol
2015-08-11 adding jtag connectors
2015-08-13 changed shield pin
2015-08-16 Adding DCC6C, SAW filter
2015-08-23 adding hole and usb
2015-09-10 start an ODB++ exporter for kicad
    [simple.kicad_pcb]
2016-04-13 Added FMC HPC Male footprint
2016-04-14 done connector
2016-04-17 adding custom QFN24 footprint
2016-04-19 adding pin array
2016-04-21 added an other qfn24 footprint :D
2016-04-25 sata footprint
2016-04-25 changed 0603 LED Footprint
2016-10-10 added 32 pin array
2016-10-11 corrected pb1024 E2/F2 pin
2016-10-11 adding EC capacitor
2016-10-19 adding fpc connector
2016-10-20 sot-236 0.95mm
2017-02-23 corrected tca0372, added SOIC16 and SMA antenna
2017-10-10 adding mini circuits package
2017-12-03 add QFN16 footprint
2017-12-03 qfn footprint
2017-12-05 adding few footprintsé
2017-12-08 adding QFN52 footprint
2017-12-17 corrected few footprint
2018-01-18 added circular hole for Jack
2018-03-22 added uFL connector
2018-05-07 adding part for the 435MHz Fusex PA
2018-06-11 added mini circuit BH292 FP
2018-09-22 adding RF devices
2018-09-23 adding footprint
2018-09-26 adding rf switch
2018-10-25 adding footprint for PA board
2018-11-04 adding few power symbol
2018-11-05 finalized AD9363 and footprint
2018-11-07 Power and testpoint
2018-12-04 adding LGA footprint for power module
2018-12-06 adding a bunch of LDO and connector footprint
2018-12-14 adding sc75 footprint
2019-02-07 adding switch
2019-02-12 Working footprint
2019-02-13 added few microstrip trace and footprint
2019-02-17 adding footprint for vna layout
2019-03-04 adding few footprint
2019-03-06 correcting pin type for passive parts
2019-03-14 added a lot of footprint
2019-03-14 adding 3D models
    [0402_1x0.5x0.35_resistor.FCStd, 0402_1x0.5x0.35_resistor.step, 12.19x12.19x7.25mm.step, 24.5x3x15.step, 3.6x3.4x2.step, 4.9x3x1.18mm.step, SMA_CINCH_142-0701-801.FCStd, SMA_CINCH_142-0701-801.step]
2019-03-31 corrected footprint
2019-04-04 adding qfn footprint
2019-05-17 a lot of 3D model
    [0.8x1.6x0.8mm.step, 0603_1.6x0.8x0.45_resistor.FCStd, 0603_1.6x0.8x0.45_resistor.step, 2.8x2.9x1mm.step, 2x2x0.55mm.step, 5x5x0.85mm.step, Antelec_AM2D_DI_S_80_60_2.5-12.3_G.FCStd, BC-144-7_0.8mm_10x10x1.3mm.FCStd]
2019-05-19 adding stencil align hole
2019-05-24 adding samtec stuff
    [FTE-130-01-G-DV.stp, QSE-014-01-F-D-DP-A.stp]
2019-05-28 added new models
    [QTE-014-01-F-D-DP-A.stp, SMD_FC_V_10x10.2mm.stp, STEP-WE-TPC-1038-rev1.stp]
2019-05-29 corrected 3D Models Path, please define CUSTLIB var in kicad project !
    [SFM-110-02-L-D-A.stp, TFM-110-01-L-D-A.stp]
2019-06-12 adding samtech connector
    [FLE-110-01-G-DV-A.stp, FTS-110-01-L-D.stp]
2019-06-24 adding nanofit connector
2019-06-25 adding connector
    [1054051106.stp, c-1981080-1-g-3d.stp, c-2294415-1-c-3d.stp]
2019-07-01 modified QSE footprint
2019-07-18 adding RPI footprint
2019-09-05 adding QTE 8mm heigth
    [QTE-014-02-F-D-DP-A.stp]
2019-09-26 adding a bunch of 3D models
    [142-0701-881.stp, 2x2x0.75mm.step, 3x3x0.85mm.step, 5x5x1.3mm.step]
2019-10-08 adding lot of RF stuff
    [0805_2x1.25x1_capacitor.step, 2x2.5x0.75mm.step, 3.5x2.5x1mm.step, 4x4x0.75mm.step]
2019-11-14 adding a lot of model
    [142-0701-841.stp, SMA_CINCH_142-0701-801.FCStd, SMA_CINCH_142-0701-801.step, TPSM84424.stp]
2019-11-22 cleaned and added 3D model for connector and various part
    [SMA_CINCH_142-0701-801_complete.FCStd, SOIC08 narrow.stp, SOIC10 narrow.stp, SOIC14 narrow.stp, SOIC16 narrow.stp, SOT23-3.stp, SOT23-4.stp, SOT23-5.stp]
2019-11-29 correcting silkscreen on DHVQFN footprint
2019-12-11 adding dc motor driver
2020-02-24 adding filter and 3D model
2020-06-26 Adding bunch of component
    [54602-908LFc.stp, 955522887.stp, D2F_L2_A1.step, EC12E2424407.step, IPL1-104-01-L-S-RA-K.stp, KSC441J DCT.stp, MicroFC_30035.step, c-726388-2-e-3d.stp]
2020-07-17 Modified LFCN symbol (adding footprint reference) and adding MCL part
2020-07-20 correctingsome footprint, incoming big rework of all the library !
2020-07-21 Adding minicircuit footprint
2020-07-22 updating mini circuit footprint
2020-07-24 updated realay 3D model
    [IM06GR.stp, IM06JR.stp]
2020-07-26 correcting component
    [a6fr-5101.stp]
2020-09-09 adding FT601 schematic
2020-09-13 adding power symbol
2020-09-15 adding usb3 connector
2020-09-30 adding models
    [692221030100_USB3.stp, SATA_10035692-011.STEP]
2021-02-18 updated footprint
2021-05-01 pushing a bunch of RF component
    [HR30-6PA-6S.stp, HR30-6R-6PD.stp, SMA_73100-0115.STEP]
2021-07-12 adding rf part
    [Stand_9774110360_11mm.stp]
2021-10-07 VFO Dial component
    [Molex_Mirco_USB_105017-0001.step]
2021-11-10 wouhou bunch of crunchy component
    [OLED 128x64.STP, asm_mx_asm_PCB.stp]
2021-11-10 always more component
    [bmi-s-209-assembly-stp-file.STEP, bmi-s-209-base.step, c-2118716-2-a-3d.stp]
2021-12-20 updating and adding a bunch, will change repo soon
    [436500303.stp, Coilcraft-1812SMS.STEP, SFP-U77A1118X00X.STEP, SMA ANGLED.STEP, STP_WE-LHMI-8030.stp, User Library-CD542.STEP]
2021-12-28 bunch of components
    [DPAK_TO252.STEP, RA60H3847M1.FCStd, RA60H3847M1.step]
2022-01-17 adding stuff
    [SMA_Vertical_5-1814832-1.stp]
2022-06-30 adding bunch of part
    [PinSocket_2x13_P2.54mm_Vertical.step, QTE-014-03-F-D-DP-A.stp, Rock PI S 3D scan.stp, fair-rite_2661000101.step]
2022-07-30 adding mega bunch of part
    [Cree_ML-X.STEP, Crystal Resonator 3.2x2.5mm.step, User Library-DF782.STEP]
2022-11-18 bunch of part
    [629105150521_USB.stp, OLED_128x64.stp, WS2812_RGB_LED_updated.stp]
2023-02-09 an other bunch of components
    [CmodS7.step, lumberg_0105_05.stp, lumberg_1503_03.stp]
2023-04-04 Updates the Better QFN generator for kicad 7
2023-04-07 a lot of crap to commit
    [878325623.stp, 9x9x1mm.step]
2023-09-03 bunch of parts
    [436500403.stp, FTSH-105-01-L-DV-K.stp]
2023-11-21 adding part
    [USB-B1HSB6.step]
2024-02-25 adding TE champ connector
    [c-2129260-1-b-3d.stp, c-2129261-1-c-3d.stp]
2024-03-02 adding parts
    [2004850740.stp]
2025-04-22 pico ezmate
    [2121340002.stp, SM04B-SURS-TF.step]
2025-05-14 add footprint
2025-05-26 updating my advanced QFN plugin for Kicad 9.0
2025-07-04 adding bunch of parts
    [B2P-VH.stp, B2PS-VH.stp]
2025-07-10 correcting footprint
2025-07-21 correcting foot print
    [691322310016.stp]
2026-01-27 led package fix
2026-03-04 correcting schematic
2026-05-17 improving footprint
2026-08-12 add 3D models
    [0705430002.stp, 2038-xx-sm.stp, 470531000.stp, 559320410.stp, 559320610.stp, 559320810.stp, PA2754NL.step, RSDW60G-12.step]
