natsfr/kicad-components/(notices)

Notices in the files:
3D_Models/ComputeUnit/PinSocket_2x13_P2.54mm_Vertical.step:
Copyright (C) 2017, Terje Io
This work is licensed under the Creative Commons CC-BY-SA 4.0 License with the following exception:
To the extent that the creation of electronic designs that use 'Licensed Material'
https://creativecommons.org/licenses/by-sa/4.0/legalcode
3D_Models/Samtec/IPL1-104-01-L-S-RA-K.stp:
FILE_NAME( 'p:/temp/worker_93/temp/exporttempdir_4672_7_VTNWP/format_0/IPL1-104-01-L-S-RA-K.stp', '2020-06-17T13:03:13', ( 'License CC BY-ND 4.0' ), ( 'CADENAS' ), ' ', 'PARTsolutions', ' ' );
3D_Models/Samtec/QTH-040-01-L-D-DP-A-K-TR.stp:
author */ ('License CC BY-ND 4.0'),
3D_Models/Connector_0.8mm/QTE-014-03-F-D-DP-A.stp:
FILE_NAME( 'e:/temp/worker_218/temp/exporttempdir_1232_385_M0o35/format_0/QTE-014-03-F-D-DP-A.stp', '2022-05-16T13:58:28', ( 'License CC BY-ND 4.0' ), ( 'CADENAS' ), ' ', 'PARTsolutions', ' ' );
